erenerdemM/Ege_Eagle_Ultrasonik/docs/GITHUB_RELEASE_PUSH_REPORT.md

# EAGLEULTRASONİK — GITHUB RELEASE PUSH REPORT

---

## 1. Executive Summary

This report documents the official release and push of the **EAGLEULTRASONiK Software / Loop Prototype Baseline** to the remote GitHub repository.

All active firmware modules, Nextion HMI assets, automated mock and physical Hardware-in-the-Loop test suites, build/flash tools, Agent OS operational rules/skills, and authoritative project documentation have been compiled, verified, committed, and pushed.

### Master Release Classification:
```text
GITHUB RELEASE — PUSHED
SOFTWARE / LOOP PROTOTYPE — READY FOR FINAL CLOSURE
FINAL HARDWARE VALIDATION — DEFERRED (DR-001, DR-002, DR-003)
```

---

## 2. Release & Remote Metadata

| Parameter | Authoritative Value |
| :--- | :--- |
| **Commit Hash** | [`6736d40d0eaaec2aaf6b98c35310447c43186bd3`](https://github.com/erenerdemM/Ege_Eagle_Ultrasonik/commit/6736d40d0eaaec2aaf6b98c35310447c43186bd3) |
| **Commit Subject** | `release: EAGLEULTRASONiK software-loop prototype baseline` |
| **Branch** | `main` |
| **Remote Repository** | `origin` (`https://github.com/erenerdemM/Ege_Eagle_Ultrasonik.git`) |
| **Push Status** | `fff821a..6736d40 main -> main` (**SUCCESS — PUSHED**) |
| **Working Tree** | Clean (`nothing to commit, working tree clean`) |

---

## 3. Git Changeset Breakdown

- **Total Staged & Committed Changes:** **232 files** (16,803 insertions, 20,205 deletions).
- **Files Modified (16 files):**
  - STM32 Core Sources: `esp32_uart.c`, `main.c`, `system_state.c`, `ultrasonic_pwm.c`, `x9c103s.c`, `heater_relay.c`, `process_timer.c`
  - STM32 Core Headers: `main.h`, `system_state.h`, `x9c103s.h`
  - ESP32 Firmware: `esp32/ekran_kontrol/ekran_kontrol.ino`
  - Nextion HMI GUI: `EKRAN/arayuz.HMI`
  - Active Test Suites: `test_hil_uart.py`, `test_hmi_mock.py`, `test_rs485_mock.py`
  - Build Script: `tools/build_stm32.sh`
- **Files Added (72 files):**
  - Authoritative Project Documentation: 64 comprehensive reports in `docs/`
  - Test & Diagnostics Tools: `id_full_lifecycle_test.py`, `list_serial_devices.py`, `live_monitor.py`
  - Build Tooling: `tools/build_stm32.ps1`
  - Developer Scratch Utilities: `scratch/restore_baseline.py`, `scratch/run_hil_tests.py`
- **Files Deleted (144 files):**
  - Historical Subagent Milestone Reports: 86 files in `.agent/reports/`
  - Root Historical Phase Reports: 58 superseded markdown drafts (`PHASE_6_2_*.md`, `FINAL_*.md`, `RS485_*.md`, etc.)

---

## 4. Pre-Release Test Verification Baseline

```text
======================================================================
  AUTOMATED VERIFICATION CAMPAIGN (100% PASS RATE):
  --------------------------------------------------------------------
  1. HMI Software Mock Suite (test_hmi_mock.py):        55 / 55 PASSED
  2. RS485 Protocol Mock Suite (test_rs485_mock.py):    37 / 37 PASSED
  3. Physical HIL Campaign (test_hil_uart.py):          40 / 40 PASSED (95.42s)
  --------------------------------------------------------------------
  TOTAL ACCEPTANCE TESTS EXECUTED:                     132 / 132 PASSED
  REGRESSION FAILURES / BLOCKED TESTS:                         0
======================================================================
```

---

## 5. Firmware Build and Hardware Flashing Verification

### 5.1 STM32 Compiler Build
- **Toolchain:** ARM GNU Toolchain (`arm-none-eabi-gcc 12.2.1`)
- **Compilation Result:** **0 Errors, 0 Warnings**
- **Memory Utilization:**
  - Flash Text: `83,304 bytes`
  - Initialized Data: `2,540 bytes`
  - BSS SRAM: `2,692 bytes`
  - Total Dec: `88,536 bytes` (Flash Usage: ~16.4% of 512KB)

### 5.2 Physical Target Flashing
- **Probe / Interface:** ST-Link V3 / OpenOCD 0.12.0 via SWD (1000 kHz)
- **Target Microcontroller:** STM32G474RET6 (`001400183235510230393936`)
- **Flashing Result:**
  ```text
  ** Programming Started **
  ** Programming Finished **
  ** Verify Started **
  ** Verified OK **
  ** Resetting Target **
  ```

---

## 6. Factory Baseline Restoration

Following test execution and firmware flashing, the physical hardware baseline was restored and verified via `scratch/restore_baseline.py`:

```text
======================================================================
  TARGET TELEMETRY READBACK (CONFIRMED):
  STAT,1,IDLE,0,589,0,0,28,0,2,0
  --------------------------------------------------------------------
  - Tank ID:            1
  - Operating Mode:     SYS_MODE_IDLE
  - Remaining Time:     0 s
  - Temperature:        58.9 °C
  - Relay State:        0 (OFF)
  - Actual Power:       0 %
  - Center Frequency:   28 kHz (Step Position 40)
  - Fault Code:         0 (NONE)
  - Provisioning State: 2 (COMMISSIONED)
  - Sweep Status:       0 (OFF)
======================================================================
```

---

## 7. Known Production & Hardware-Deferred Items

1. **Production Software Improvements (Non-Blocking):**
   - `RSK-010`: Flash-erase interrupt masking improvement before production.
   - `RSK-013`: CRC8 checksum protection enhancement for ASCII telemetry frames.
   - `RSK-011`, `RSK-012`, `RSK-014`, `RSK-015`: Usability and architectural refinements accepted for later production phases.
2. **Physical Hardware Validation (Hardware-Deferred):**
   - `DR-001`: Physical PT100 probe RTD calibration and 220V AC heater load validation.
   - `DR-002`: Physical ultrasonic transducer acoustic resonance tracking across 25–43 kHz.
   - `DR-003`: Physical liquid tank cavitation dissolved oxygen (DO) PPM reduction validation.

---

## 8. Final Status

```text
GITHUB RELEASE — PUSHED
```

The repository has been pruned, fully tested, built, flashed, restored to baseline, committed, and pushed to GitHub `origin/main`.

---
*Report generated on 2026-08-17. Release lifecycle complete.*
