erenerdemM/Ege_Eagle_Ultrasonik/docs/P1_BATCH1_IMPLEMENTATION_REPORT.md

# EAGLEULTRASONİK — P1 REMEDIATION BATCH #1 IMPLEMENTATION REPORT

---

## 1. Executive Summary

This report documents the implementation, build, physical flashing, and multi-tier verification of **P1 Remediation Batch #1** for the EAGLEULTRASONiK dual-core ultrasonic generator platform.

Batch #1 targets the three STM32 firmware and low-level protocol risks identified during Phase 15 triage:
- **RSK-005:** Telemetry Buffer Safety (`snprintf` buffer over-read clamping)
- **RSK-007:** UART Error Recovery (ORE/FE/NE/PE error clearing & deterministic RX re-arm)
- **RSK-006:** DEGAS Mode Provisioning Interlock (Layer 2 commissioning lockout in `SYS_MODE_DEGAS`)

All three risks were remediated through surgical, minimal-diff modifications strictly within the STM32 UART subsystem, followed by clean builds, physical target programming via OpenOCD SWD, targeted regression verification, and full regression testing across both mock and physical HIL environments.

### Master Batch Status:
```text
P1 BATCH #1 REMEDIATION — COMPLETE (RSK-005: PASS | RSK-007: PASS | RSK-006: PASS)
```

---

## 2. Risk-by-Risk Implementation Details

### 2.1 RSK-005 Implementation (Telemetry Buffer Boundary Clamping)
* **Target File:** [`STM32/Ultrasonik_G4_Master/Core/Src/esp32_uart.c:732-758`](file:///c:/Users/ern0e/EAGLEULTRASONiK/STM32/Ultrasonik_G4_Master/Core/Src/esp32_uart.c#L732-L758)
* **Root Cause:** `snprintf()` returns the total length that *would have been written* if the buffer were unbounded (ISO C99 §7.19.6.5). If formatting expanded beyond `TX_LINE_MAX` (64 bytes), passing raw `len` to `HAL_UART_Transmit_IT` resulted in an out-of-bounds buffer read from SRAM.
* **Remediation Applied:** Added deterministic upper-bound clamping to `len`:
  ```c
  if (len <= 0)
  {
    return;
  }

  if (len >= TX_LINE_MAX)
  {
    len = TX_LINE_MAX - 1;
    tx_line[len] = '\0';
  }

  tx_busy = 1;
  g_bus_diag.tx_frame_count++;
  RS485_TX_ENABLE();
  HAL_UART_Transmit_IT(&huart3, (uint8_t *)tx_line, (uint16_t)len);
  ```
* **Acceptance Invariants Met:** Transmitted length strictly bounded by `TX_LINE_MAX - 1` (63 bytes); normal STAT telemetry framing and 10-field CSV schema perfectly preserved.

---

### 2.2 RSK-007 Implementation (Deterministic UART RX Error Recovery)
* **Target File:** [`STM32/Ultrasonik_G4_Master/Core/Src/esp32_uart.c:808-832`](file:///c:/Users/ern0e/EAGLEULTRASONiK/STM32/Ultrasonik_G4_Master/Core/Src/esp32_uart.c#L808-L832)
* **Root Cause:** In `HAL_UART_ErrorCallback()`, Overrun (ORE), Framing (FE), Noise (NE), and Parity (PE) error flags in USART3 ISR registers were not explicitly cleared, and the return value of `HAL_UART_Receive_IT` was ignored. If the driver state remained locked or busy, RX failed to re-arm, permanently silencing the slave node.
* **Remediation Applied:** Explicitly cleared all hardware error flags, reset HAL error state, and implemented a fail-safe abort-and-rearm fallback if the initial `HAL_UART_Receive_IT` call returns non-OK:
  ```c
  void HAL_UART_ErrorCallback(UART_HandleTypeDef *huart)
  {
    if (huart->Instance != USART3)
    {
      return;
    }

    /* Clear all UART error flags (Overrun, Noise, Framing, Parity) */
    __HAL_UART_CLEAR_OREFLAG(huart);
    __HAL_UART_CLEAR_NEFLAG(huart);
    __HAL_UART_CLEAR_FEFLAG(huart);
    __HAL_UART_CLEAR_PEFLAG(huart);
    huart->ErrorCode = HAL_UART_ERROR_NONE;

    /* Overrun/framing/noise errors abort the pending HAL_UART_Receive_IT();
     * discard the partial line and immediately re-arm so a single glitch
     * never permanently silences the link (RX must never be left dead). */
    RS485_RX_ENABLE();
    rx_index = 0;
    g_bus_diag.rx_dropped_count++;
    tx_busy = 0; /* Reset TX lockup state so status transmission recovers after error */

    if (HAL_UART_Receive_IT(&huart3, &rx_byte, 1) != HAL_OK)
    {
      /* If re-arm failed due to state lock, force abort receive and re-arm deterministically */
      (void)HAL_UART_AbortReceive(&huart3);
      (void)HAL_UART_Receive_IT(&huart3, &rx_byte, 1);
    }
  }
  ```
* **Acceptance Invariants Met:** Zero blocking loops or delays in ISR; all hardware error flags cleared; RX path deterministically re-armed.

---

### 2.3 RSK-006 Implementation (DEGAS Mode Provisioning Interlock)
* **Target File:** [`STM32/Ultrasonik_G4_Master/Core/Src/esp32_uart.c:224-239`](file:///c:/Users/ern0e/EAGLEULTRASONiK/STM32/Ultrasonik_G4_Master/Core/Src/esp32_uart.c#L224-L239)
* **Root Cause:** Layer 2 commissioning command interlocks (`STAGE_ID`, `ASSIGN_ID`, `SET_ID:`, `RESET_ID`, `DISCOVER`, `COMMIT_ID`) only checked `g_system_state.mode == SYS_MODE_RUNNING`, permitting flash erase/write operations and identity mutations during active `SYS_MODE_DEGAS`.
* **Remediation Applied:** Extended the Layer 2 interlock check to include `SYS_MODE_DEGAS`:
  ```c
  /* Requirement 2: Layer 2 SYS_MODE_RUNNING and SYS_MODE_DEGAS Interlock at STM32 Slave Level */
  if (g_system_state.mode == SYS_MODE_RUNNING || g_system_state.mode == SYS_MODE_DEGAS)
  {
    if (strncmp(cmd, "STAGE_ID", 8) == 0  ||
        strncmp(cmd, "ASSIGN_ID", 9) == 0 ||
        strncmp(cmd, "SET_ID:", 7) == 0   ||
        strncmp(cmd, "RESET_ID", 8) == 0  ||
        strncmp(cmd, "DISCOVER", 8) == 0  ||
        strncmp(cmd, "COMMIT_ID", 9) == 0)
    {
      const char *err_msg = "ERR:LOCKED_SYS_RUNNING\n";
      RS485_Transmit_Blocking((const uint8_t *)err_msg, (uint16_t)strlen(err_msg), 10);
      HAL_UART_Transmit(&hlpuart1, (const uint8_t *)err_msg, (uint16_t)strlen(err_msg), 10);
      return; /* REJECT IMMEDIATELY; NO FLASH TOUCH OR STATE MUTATION */
    }
  }
  ```
* **Acceptance Invariants Met:** Full mode symmetry restored; commissioning commands strictly rejected during both `RUNNING` and `DEGAS`; normal commissioning remains 100% operational in `IDLE`.

---

## 3. Files Changed

| Modified File | Subsystem | Purpose of Modification | Lines Changed |
| :--- | :--- | :--- | :--- |
| [`STM32/.../Core/Src/esp32_uart.c`](file:///c:/Users/ern0e/EAGLEULTRASONiK/STM32/Ultrasonik_G4_Master/Core/Src/esp32_uart.c) | STM32 Firmware | Implemented RSK-005 buffer clamp, RSK-007 error flags/re-arm, RSK-006 DEGAS interlock | +22 / -4 |
| [`test_rs485_mock.py`](file:///c:/Users/ern0e/EAGLEULTRASONiK/test_rs485_mock.py) | Mock Test Suite | Added mock regression tests for RSK-005, RSK-006, RSK-007; updated mock slave node interlock | +48 / -2 |
| [`test_hil_uart.py`](file:///c:/Users/ern0e/EAGLEULTRASONiK/test_hil_uart.py) | Physical HIL Suite | Added physical HIL regression tests for RSK-005, RSK-006, RSK-007; aligned CLEAR_FAULT recovery in setup/tests | +52 / -4 |

---

## 4. Regression Tests Added

1. **`test_rsk005_telemetry_buffer_boundary_clamping`:**
   - **Mock Suite:** [`test_rs485_mock.py:788`](file:///c:/Users/ern0e/EAGLEULTRASONiK/test_rs485_mock.py#L788)
   - **Physical HIL Suite:** [`test_hil_uart.py:1347`](file:///c:/Users/ern0e/EAGLEULTRASONiK/test_hil_uart.py#L1347)
   - **Verification:** Formatted STAT frame length strictly bounded by buffer capacity ($\le 63$ chars); valid parsing verified.

2. **`test_rsk006_degas_mode_provisioning_command_rejection`:**
   - **Mock Suite:** [`test_rs485_mock.py:797`](file:///c:/Users/ern0e/EAGLEULTRASONiK/test_rs485_mock.py#L797)
   - **Physical HIL Suite:** [`test_hil_uart.py:1355`](file:///c:/Users/ern0e/EAGLEULTRASONiK/test_hil_uart.py#L1355)
   - **Verification:** STAGE_ID and commissioning commands sent during DEGAS mode are immediately rejected with zero identity or state mutation.

3. **`test_rsk007_uart_rx_error_callback_rearm_guarantee`:**
   - **Mock Suite:** [`test_rs485_mock.py:805`](file:///c:/Users/ern0e/EAGLEULTRASONiK/test_rs485_mock.py#L805)
   - **Physical HIL Suite:** [`test_hil_uart.py:1378`](file:///c:/Users/ern0e/EAGLEULTRASONiK/test_hil_uart.py#L1378)
   - **Verification:** Simulates error callback / corrupted line injections; verifies USART3 RX immediately resumes and delivers clean telemetry frames.

---

## 5. Targeted Test Results

```text
============================= test session starts ==============================
test_hil_uart.py::HardwareInLoopTests::test_rsk001_active_hardware_fault_stop_rejection PASSED [ 16%]
test_hil_uart.py::HardwareInLoopTests::test_rsk002_hil_uart_spinlock_timeout_guard PASSED [ 33%]
test_hil_uart.py::HardwareInLoopTests::test_rsk003_hil_setpoint_touch_lockout_in_running PASSED [ 50%]
test_hil_uart.py::HardwareInLoopTests::test_rsk005_telemetry_buffer_boundary_clamping PASSED [ 66%]
test_hil_uart.py::HardwareInLoopTests::test_rsk006_degas_mode_provisioning_command_rejection PASSED [ 83%]
test_hil_uart.py::HardwareInLoopTests::test_rsk007_uart_rx_error_callback_rearm_guarantee PASSED [100%]

======================= 6 passed, 31 deselected in 7.56s =======================
```

---

## 6. Full Regression Results

### 6.1 Mock Test Suites (Host Environment)
```text
test_hmi_mock.py .................................................... [ 58%]
test_rs485_mock.py ...................................                [100%]

============================= 89 passed in 0.26s ==============================
```

### 6.2 Physical Hardware-in-the-Loop Suite (`test_hil_uart.py` on Raspberry Pi)
```text
test_hil_uart.py::HardwareInLoopTests::test_01_id_assignment PASSED      [  2%]
test_hil_uart.py::HardwareInLoopTests::test_02_parameter_transmission PASSED [  5%]
test_hil_uart.py::HardwareInLoopTests::test_03_operation_cycle PASSED    [  8%]
test_hil_uart.py::HardwareInLoopTests::test_04_stop_clears_fault PASSED  [ 10%]
test_hil_uart.py::HardwareInLoopTests::test_05_dual_channel_consistency PASSED [ 13%]
test_hil_uart.py::HardwareInLoopTests::test_06_triac_math PASSED         [ 16%]
test_hil_uart.py::HardwareInLoopTests::test_07_pt100_adc PASSED          [ 18%]
test_hil_uart.py::HardwareInLoopTests::test_08_esp32_internals PASSED    [ 21%]
test_hil_uart.py::HardwareInLoopTests::test_09_id0_discovery_slotted PASSED [ 24%]
test_hil_uart.py::HardwareInLoopTests::test_10_id0_discovery_multi_simulated PASSED [ 27%]
test_hil_uart.py::HardwareInLoopTests::test_11_uid_mismatch_rejection PASSED [ 29%]
test_hil_uart.py::HardwareInLoopTests::test_12_id_duplicate_rejection PASSED [ 32%]
test_hil_uart.py::HardwareInLoopTests::test_13_atomic_swap_flow PASSED   [ 35%]
test_hil_uart.py::HardwareInLoopTests::test_14_staging_discovery_isolation PASSED [ 37%]
test_hil_uart.py::HardwareInLoopTests::test_15_running_commissioning_rejection PASSED [ 40%]
test_hil_uart.py::HardwareInLoopTests::test_16_safety_watchdog_comm_loss PASSED [ 43%]
test_hil_uart.py::HardwareInLoopTests::test_17_physical_loopback_readback PASSED [ 45%]
test_hil_uart.py::HardwareInLoopTests::test_deg_01_full_degas_hil_lifecycle PASSED [ 48%]
test_hil_uart.py::HardwareInLoopTests::test_f1_set_freq_28 PASSED        [ 51%]
test_hil_uart.py::HardwareInLoopTests::test_f2_set_freq_40 PASSED        [ 54%]
test_hil_uart.py::HardwareInLoopTests::test_f3_set_freq_invalid PASSED   [ 56%]
test_hil_uart.py::HardwareInLoopTests::test_rsk001_active_hardware_fault_stop_rejection PASSED [ 59%]
test_hil_uart.py::HardwareInLoopTests::test_rsk002_hil_uart_spinlock_timeout_guard PASSED [ 62%]
test_hil_uart.py::HardwareInLoopTests::test_rsk003_hil_setpoint_touch_lockout_in_running PASSED [ 64%]
test_hil_uart.py::HardwareInLoopTests::test_rsk005_telemetry_buffer_boundary_clamping PASSED [ 67%]
test_hil_uart.py::HardwareInLoopTests::test_rsk006_degas_mode_provisioning_command_rejection PASSED [ 70%]
test_hil_uart.py::HardwareInLoopTests::test_rsk007_uart_rx_error_callback_rearm_guarantee PASSED [ 72%]
test_hil_uart.py::HardwareInLoopTests::test_swp_01_idle_sweep_off_and_on PASSED [ 75%]
test_hil_uart.py::HardwareInLoopTests::test_swp_02_start_with_and_without_sweep PASSED [ 78%]
test_hil_uart.py::HardwareInLoopTests::test_swp_03_set_freq_terminates_sweep PASSED [ 81%]
test_hil_uart.py::HardwareInLoopTests::test_swp_04_step_increment_configuration PASSED [ 83%]
test_hil_uart.py::HardwareInLoopTests::test_swp_05_degas_mode_sweep_interlock PASSED [ 86%]
test_hil_uart.py::HardwareInLoopTests::test_swp_06_sweep_span_configuration PASSED [ 89%]
test_hil_uart.py::HardwareInLoopTests::test_swp_07_sweep_period_configuration PASSED [ 91%]
test_hil_uart.py::HardwareInLoopTests::test_swp_08_parameter_independence PASSED [ 94%]
test_hil_uart.py::HardwareInLoopTests::test_swp_09_stop_safestop_cleanup_and_persistence PASSED [ 97%]
test_hil_uart.py::HardwareInLoopTests::test_swp_10_endurance_stability_sample PASSED [100%]

======================== 37 passed in 90.32s (0:01:30) =========================
```

---

## 7. Build and Physical Flash Verification

### 7.1 Compilation Output (ARM GNU Toolchain 13.3.rel1)
* **Windows Clean Build:** `build-stm32/Ultrasonik_G4_Master.elf` (0 errors, 0 warnings)
  ```text
     text    data     bss     dec     hex filename
    67968    1804    3412   73184   11de0 Ultrasonik_G4_Master.elf
  ```
* **RPi Clean Build:** `build-stm32/Ultrasonik_G4_Master.elf` (0 errors, 0 warnings)
  ```text
     text    data     bss     dec     hex filename
    83304    2540    2692   88536   159d8 Ultrasonik_G4_Master.elf
  ```

### 7.2 OpenOCD SWD Programming Log
* **Target Hardware:** STM32G474RET6 (UID24 `001400183235510230393936`)
* **Interface:** ST-LINK V3J16M9 via SWD @ 1000 kHz
* **Flash Operations:**
  ```text
  ** Programming Started **
  Info : device idcode = 0x20036469 (STM32G47/G48xx - Rev 'unknown' : 0x2003)
  Info : RDP level 0 (0xAA)
  Info : flash size = 512 KiB
  Info : flash mode : dual-bank
  ** Programming Finished **
  ** Verify Started **
  ** Verified OK **
  ** Resetting Target **
  ```

---

## 8. Blocked and Deferred Tests Reconciliation

* **Blocked Tests (12 items):** In earlier test runs where transient fault states prevented mode transitions, 12 AC mains zero-cross dependent tests were blocked. With the addition of deterministic `CLEAR_FAULT` in `setUp()` and the baseline restoration procedure, **all 37 physical HIL tests ran cleanly to PASS status** in the full regression run.
* **Deferred Test (DR-001):** `test_17_physical_loopback_readback` was executed and **PASSED** on the active test channel.

---

## 9. Baseline Restoration Record

Following completion of the test suite, the physical DUT was restored to the authoritative baseline state via automated script:

```text
Restored Authoritative Defaults:
  - Mode: IDLE
  - Tank ID: 1 (UID: 001400183235510230393936)
  - Frequency: 28 kHz
  - Power: 100%
  - Fault Flags: 0x00 (Clean)
  - Sweep: OFF (span: 2 kHz, period: 400 ms, step inc: 4)
  - DEGAS Config: 15 min, 100% power, 28 kHz, ON: 1000 ms, OFF: 500 ms, Temp Ctrl: OFF (50 °C)

Telemetry Readback Confirmation:
  STAT,1,IDLE,0,603,0,0,28,0,2,0
  STAT,1,IDLE,0,595,0,0,28,0,2,0
  STAT,1,IDLE,0,596,0,0,28,0,2,0
  STAT,1,IDLE,0,592,0,0,28,0,2,0
  STAT,1,IDLE,0,595,0,0,28,0,2,0
```

---

## 10. Remaining Active P1 Risks Ledger

With Batch #1 complete, the remaining P1 risks in the project registry are:

| Risk ID | Title | Target Area | Batch Status | Next Scheduled Phase |
| :--- | :--- | :--- | :--- | :--- |
| **RSK-009** | Stale UI Status After RS485 Disconnection | ESP32 HMI Watchdog | OPEN | **P1 Remediation Batch #2** |
| **RSK-004** | ESP32 Master Response Blind Spot (ACK/NACK/ERR) | ESP32 Protocol Parser | OPEN | **P1 Remediation Batch #2** |
| **RSK-008** | Unauthenticated Administrative Commands | ESP32 HMI Security / NVS | OPEN | **P1 Remediation Batch #2** |

---

## 11. Final Risk Status Determination

| Risk ID | Title | Final Verification Status | Evidence Level |
| :--- | :--- | :--- | :--- |
| **RSK-005** | Telemetry Buffer Safety (`snprintf` clamp) | **PASS** | Physical HIL + Mock Suite Verified |
| **RSK-007** | UART Error Recovery (ORE/FE/NE/PE re-arm) | **PASS** | Physical HIL + Mock Suite Verified |
| **RSK-006** | DEGAS Mode Provisioning Interlock | **PASS** | Physical HIL + Mock Suite Verified |

---
*Report generated and validated under Phase 16: P1 Remediation Batch #1. Zero unrelated modules were modified.*
