erenerdemM/Ege_Eagle_Ultrasonik/docs/P1_BATCH2_IMPLEMENTATION_REPORT.md

# EAGLEULTRASONİK — P1 REMEDIATION BATCH #2 IMPLEMENTATION REPORT

---

## 1. Executive Summary

This report documents the implementation, integration, mock verification, and physical Hardware-in-the-Loop (HIL) verification of **P1 Remediation Batch #2** for the EAGLEULTRASONiK controller system.

Batch #2 targets the remaining three Priority 1 (P1) risks:
- **RSK-004:** ESP32 Master Response Blind Spot (`ACK:`, `NACK:`, `ERR:` frame parsing and Nextion HMI feedback)
- **RSK-008:** Service / Admin Command Authorization (`isProvisioningAllowed()` PIN gating on `CMD_SET_STEP_INC:`, `CMD_SET_SWP_SPAN:`, `CMD_SET_SWP_PER:`, `P_SAVE|...`)
- **RSK-009:** RS485 Disconnect / Stale HMI State Synchronization (`durum_metni[i] = "Kart Yok!"`, clearing process flags on 3000ms timeout)

All modifications were applied to [`esp32/ekran_kontrol/ekran_kontrol.ino`](file:///c:/Users/ern0e/EAGLEULTRASONiK/esp32/ekran_kontrol/ekran_kontrol.ino) and fully mirrored in [`test_hmi_mock.py`](file:///c:/Users/ern0e/EAGLEULTRASONiK/test_hmi_mock.py) and [`test_hil_uart.py`](file:///c:/Users/ern0e/EAGLEULTRASONiK/test_hil_uart.py).

### Master Status:
```text
P1 BATCH #2 REMEDIATION — COMPLETE (RSK-004: PASS | RSK-008: PASS | RSK-009: PASS)
ALL SIX P1 RISKS (RSK-004 .. RSK-009) ARE NOW FULLY CLOSED
```

---

## 2. Risk-by-Risk Implementation Details

### 2.1 RSK-004 Implementation (ESP32 Master ACK/NACK/ERR Parser)
* **Target File:** [`esp32/ekran_kontrol/ekran_kontrol.ino:581-610`](file:///c:/Users/ern0e/EAGLEULTRASONiK/esp32/ekran_kontrol/ekran_kontrol.ino#L581-L610)
* **Root Cause:** `stmTelemetryIsle(String satir)` previously discarded any line not starting with `"STAT,"`, causing all acknowledgment, error, and rejection frames (`ERR:LOCKED_ACTIVE_MODE`, `ERR:LOCKED_SYS_RUNNING`, `NACK,ERR_FAULT_ACTIVE`, `ACK:FAULT_CLEARED`) sent by STM32 slaves to be silently ignored.
* **Remediation Applied:** Added explicit branches in `stmTelemetryIsle` to intercept slave response frames before telemetry parsing:
  ```cpp
  void stmTelemetryIsle(String satir) {
    if (satir.startsWith("ERR:") || satir.startsWith("NACK")) {
      Serial.println("--> STM32 REJECTION: " + satir);
      if (satir.startsWith("ERR:LOCKED_ACTIVE_MODE") || satir.startsWith("ERR:LOCKED_SYS_RUNNING")) {
        durum_metni[secili_goz] = "HATA: CALISIYOR!";
      } else if (satir.startsWith("ERR:SWEEP_PROHIBITED_IN_DEGAS")) {
        durum_metni[secili_goz] = "HATA: DEGAS AKTIF!";
      } else if (satir.startsWith("ERR:INVALID_SYS_MODE")) {
        durum_metni[secili_goz] = "HATA: GECERSIZ MOD!";
      } else if (satir.startsWith("NACK,ERR_FAULT_ACTIVE")) {
        durum_metni[secili_goz] = "HATA: ARIZA AKTIF!";
      } else {
        durum_metni[secili_goz] = "HATA: " + satir.substring(0, 16);
      }
      nextionGonder("t_durum.txt=\"" + durum_metni[secili_goz] + "\"");
      return;
    }

    if (satir.startsWith("ACK:") || satir.startsWith("ACK,") || satir.startsWith("DISCOVER_ACK,")) {
      Serial.println("--> STM32 ACK: " + satir);
      if (satir.startsWith("ACK:FAULT_CLEARED") || satir.startsWith("ACK:NO_FAULT")) {
        if (durum_metni[secili_goz].startsWith("HATA")) {
          durum_metni[secili_goz] = "SISTEM BEKLEMEDE";
          nextionGonder("t_durum.txt=\"" + durum_metni[secili_goz] + "\"");
        }
      }
      return;
    }

    if (!satir.startsWith("STAT,")) return;
    ...
  ```
* **Acceptance Invariants Met:** Rejection frames immediately update operator status on Nextion HMI; STAT frame parsing remains unaffected.

---

### 2.2 RSK-008 Implementation (Service PIN Authorization on Admin & Recipe Commands)
* **Target File:** [`esp32/ekran_kontrol/ekran_kontrol.ino:977-1180`](file:///c:/Users/ern0e/EAGLEULTRASONiK/esp32/ekran_kontrol/ekran_kontrol.ino#L977-L1180)
* **Root Cause:** Command handlers for `P_SAVE|...`, `CMD_SET_STEP_INC:`, `CMD_SET_SWP_SPAN:`, and `CMD_SET_SWP_PER:` lacked `if (!isProvisioningAllowed()) return;` checks, allowing unauthorized serial frame injection or unauthenticated screen actions to mutate persistent NVS configuration.
* **Remediation Applied:** Added `if (!isProvisioningAllowed())` guards to all four target command handlers:
  ```cpp
  // --- PROGRAM KAYDETME (Page 2) ---
  else if (komut.startsWith("P_SAVE|")) {
    if (!isProvisioningAllowed()) {
      Serial.println("--> AUTH REJECTED: SERVICE PIN REQUIRED FOR RECIPE SAVE");
      return;
    }
    if (degas_active[secili_goz] || makine_calisiyor[secili_goz]) {
      Serial.println("--> RECIPE SAVE LOCKED: PROCESS IS ACTIVE!");
      return;
    }
    ...
  }
  ...
  else if (komut.startsWith("CMD_SET_STEP_INC:") || komut.startsWith("SET_STEP_INC:")) {
    if (!isProvisioningAllowed()) {
      Serial.println("--> AUTH REJECTED: SERVICE PIN REQUIRED FOR SWEEP STEP INC");
      return;
    }
    ...
  }
  else if (komut.startsWith("CMD_SET_SWP_SPAN:") || komut.startsWith("SET_SWP_SPAN:") || komut.startsWith("SET_SPAN:")) {
    if (!isProvisioningAllowed()) {
      Serial.println("--> AUTH REJECTED: SERVICE PIN REQUIRED FOR SWEEP SPAN");
      return;
    }
    ...
  }
  else if (komut.startsWith("CMD_SET_SWP_PER:") || komut.startsWith("SET_SWP_PER:") || komut.startsWith("SET_PER:")) {
    if (!isProvisioningAllowed()) {
      Serial.println("--> AUTH REJECTED: SERVICE PIN REQUIRED FOR SWEEP PERIOD");
      return;
    }
    ...
  }
  ```
* **Acceptance Invariants Met:** Unauthenticated attempts are strictly rejected; valid service session ("123456") executes changes and persists to NVS; no redundant independent authentication mechanism created.

---

### 2.3 RSK-009 Implementation (RS485 Disconnect UI Synchronization)
* **Target File:** [`esp32/ekran_kontrol/ekran_kontrol.ino:1452-1466`](file:///c:/Users/ern0e/EAGLEULTRASONiK/esp32/ekran_kontrol/ekran_kontrol.ino#L1452-L1466)
* **Root Cause:** When `millis() - stm_son_veri_zamani[i] > STM_BAGLANTI_TIMEOUT` (3000ms), `stm_bagli[i]` was cleared to `false` but `durum_metni[i]` was left unmodified, causing Nextion HMI to display stale strings like `"YIKAMA DEVAM EDIYOR..."` during communication failure.
* **Remediation Applied:** Updated the connection watchdog loop to clear countdown timer and immediately push `"Kart Yok!"` to Nextion HMI:
  ```cpp
  // --- Bağlantı zaman aşımı kontrolü (her göz/tank bagimsiz) ---
  for (int i = 1; i < MAX_GOZ; i++) {
    if (stm_bagli[i] && (millis() - stm_son_veri_zamani[i] > STM_BAGLANTI_TIMEOUT)) {
      stm_bagli[i] = false;
      makine_calisiyor[i] = false;
      degas_active[i] = false;
      degas_armed[i] = false;
      stm_relay[i] = 0;
      kalan_saniye[i] = 0;
      durum_metni[i] = "Kart Yok!";
      if (i == secili_goz) {
        nextionGonder("t_durum.txt=\"Kart Yok!\"");
        nextionGonder("t_status.txt=\"Kart Yok!\"");
        nextionGonder("b_degas.bco=" + String(NEXTION_COLOR_DEFAULT));
      }
    }
  }
  ```
* **Acceptance Invariants Met:** Nextion display immediately updates to `"Kart Yok!"` on timeout; zero auto-restart; multi-tank state isolation preserved.

---

## 3. Files Changed

| Modified File | Subsystem | Purpose of Modification |
| :--- | :--- | :--- |
| [`esp32/ekran_kontrol/ekran_kontrol.ino`](file:///c:/Users/ern0e/EAGLEULTRASONiK/esp32/ekran_kontrol/ekran_kontrol.ino) | ESP32 Firmware | Implemented RSK-004 response parsing, RSK-008 service PIN auth, RSK-009 watchdog UI sync |
| [`test_hmi_mock.py`](file:///c:/Users/ern0e/EAGLEULTRASONiK/test_hmi_mock.py) | Mock Test Suite | Mirrored ESP32 firmware logic, updated `test_09`, added `test_rsk004`, `test_rsk008`, `test_rsk009` |
| [`test_hil_uart.py`](file:///c:/Users/ern0e/EAGLEULTRASONiK/test_hil_uart.py) | Physical HIL Suite | Added physical HIL regression tests for `test_rsk004`, `test_rsk008`, `test_rsk009` |

---

## 4. Tests Added

1. **`test_rsk004_hmi_parses_slave_error_and_nack_frames`:**
   - **Mock Suite:** [`test_hmi_mock.py:1450`](file:///c:/Users/ern0e/EAGLEULTRASONiK/test_hmi_mock.py#L1450)
   - **Physical HIL Suite:** [`test_hil_uart.py:1388`](file:///c:/Users/ern0e/EAGLEULTRASONiK/test_hil_uart.py#L1388)
   - **Verification:** Injects rejection frames (`ERR:LOCKED_ACTIVE_MODE`, `NACK,ERR_FAULT_ACTIVE`); verifies `durum_metni` and Nextion display updates.

2. **`test_rsk008_admin_sweep_and_recipe_save_pin_lockout`:**
   - **Mock Suite:** [`test_hmi_mock.py:1459`](file:///c:/Users/ern0e/EAGLEULTRASONiK/test_hmi_mock.py#L1459)
   - **Physical HIL Suite:** [`test_hil_uart.py:1399`](file:///c:/Users/ern0e/EAGLEULTRASONiK/test_hil_uart.py#L1399)
   - **Verification:** Unauthenticated `P_SAVE`, `CMD_SET_STEP_INC`, `CMD_SET_SWP_SPAN`, `CMD_SET_SWP_PER` are rejected; authenticated execution succeeds.

3. **`test_rsk009_hmi_timeout_updates_durum_metni_kart_yok`:**
   - **Mock Suite:** [`test_hmi_mock.py:1490`](file:///c:/Users/ern0e/EAGLEULTRASONiK/test_hmi_mock.py#L1490)
   - **Physical HIL Suite:** [`test_hil_uart.py:1418`](file:///c:/Users/ern0e/EAGLEULTRASONiK/test_hil_uart.py#L1418)
   - **Verification:** Advances clock past 3000ms timeout; verifies `durum_metni == "Kart Yok!"` and `makine_calisiyor == False`.

---

## 5. Targeted Test Results

```text
test_hmi_mock.py::TestHMIDEGASStateSuite::test_rsk004_hmi_parses_slave_error_and_nack_frames PASSED
test_hmi_mock.py::TestHMIDEGASStateSuite::test_rsk008_admin_sweep_and_recipe_save_pin_lockout PASSED
test_hmi_mock.py::TestHMIDEGASStateSuite::test_rsk009_hmi_timeout_updates_durum_metni_kart_yok PASSED
```

---

## 6. Full Mock Regression Results

```text
test_hmi_mock.py ........................................................... [ 60%]
test_rs485_mock.py ...................................                       [100%]

============================= 92 passed in 0.26s ==============================
```

---

## 7. Physical Hardware-in-the-Loop Results (`test_hil_uart.py` on Raspberry Pi)

```text
============================= test session starts ==============================
platform linux -- Python 3.11.2, pytest-9.1.1, pluggy-1.6.0 -- /usr/bin/python3
cachedir: .pytest_cache
rootdir: /home/eren/EAGLEULTRASONiK
collecting ... collected 40 items

test_hil_uart.py::HardwareInLoopTests::test_01_id_assignment PASSED      [  2%]
test_hil_uart.py::HardwareInLoopTests::test_02_parameter_transmission PASSED [  5%]
test_hil_uart.py::HardwareInLoopTests::test_03_operation_cycle PASSED    [  7%]
test_hil_uart.py::HardwareInLoopTests::test_04_stop_clears_fault PASSED  [ 10%]
test_hil_uart.py::HardwareInLoopTests::test_05_dual_channel_consistency PASSED [ 12%]
test_hil_uart.py::HardwareInLoopTests::test_06_triac_math PASSED         [ 15%]
test_hil_uart.py::HardwareInLoopTests::test_07_pt100_adc PASSED          [ 17%]
test_hil_uart.py::HardwareInLoopTests::test_08_esp32_internals PASSED    [ 20%]
test_hil_uart.py::HardwareInLoopTests::test_09_id0_discovery_slotted PASSED [ 22%]
test_hil_uart.py::HardwareInLoopTests::test_10_id0_discovery_multi_simulated PASSED [ 25%]
test_hil_uart.py::HardwareInLoopTests::test_11_uid_mismatch_rejection PASSED [ 27%]
test_hil_uart.py::HardwareInLoopTests::test_12_id_duplicate_rejection PASSED [ 30%]
test_hil_uart.py::HardwareInLoopTests::test_13_atomic_swap_flow PASSED   [ 32%]
test_hil_uart.py::HardwareInLoopTests::test_14_staging_discovery_isolation PASSED [ 35%]
test_hil_uart.py::HardwareInLoopTests::test_15_running_commissioning_rejection PASSED [ 37%]
test_hil_uart.py::HardwareInLoopTests::test_16_safety_watchdog_comm_loss PASSED [ 40%]
test_hil_uart.py::HardwareInLoopTests::test_17_physical_loopback_readback PASSED [ 42%]
test_hil_uart.py::HardwareInLoopTests::test_deg_01_full_degas_hil_lifecycle PASSED [ 45%]
test_hil_uart.py::HardwareInLoopTests::test_f1_set_freq_28 PASSED        [ 47%]
test_hil_uart.py::HardwareInLoopTests::test_f2_set_freq_40 PASSED        [ 50%]
test_hil_uart.py::HardwareInLoopTests::test_f3_set_freq_invalid PASSED   [ 52%]
test_hil_uart.py::HardwareInLoopTests::test_rsk001_active_hardware_fault_stop_rejection PASSED [ 55%]
test_hil_uart.py::HardwareInLoopTests::test_rsk002_hil_uart_spinlock_timeout_guard PASSED [ 57%]
test_hil_uart.py::HardwareInLoopTests::test_rsk003_hil_setpoint_touch_lockout_in_running PASSED [ 60%]
test_hil_uart.py::HardwareInLoopTests::test_rsk004_hmi_parses_slave_error_and_nack_frames PASSED [ 62%]
test_hil_uart.py::HardwareInLoopTests::test_rsk005_telemetry_buffer_boundary_clamping PASSED [ 65%]
test_hil_uart.py::HardwareInLoopTests::test_rsk006_degas_mode_provisioning_command_rejection PASSED [ 67%]
test_hil_uart.py::HardwareInLoopTests::test_rsk007_uart_rx_error_callback_rearm_guarantee PASSED [ 70%]
test_hil_uart.py::HardwareInLoopTests::test_rsk008_admin_sweep_and_recipe_save_pin_lockout PASSED [ 72%]
test_hil_uart.py::HardwareInLoopTests::test_rsk009_hmi_timeout_updates_durum_metni_kart_yok PASSED [ 75%]
test_hil_uart.py::HardwareInLoopTests::test_swp_01_idle_sweep_off_and_on PASSED [ 77%]
test_hil_uart.py::HardwareInLoopTests::test_swp_02_start_with_and_without_sweep PASSED [ 80%]
test_hil_uart.py::HardwareInLoopTests::test_swp_03_set_freq_terminates_sweep PASSED [ 82%]
test_hil_uart.py::HardwareInLoopTests::test_swp_04_step_increment_configuration PASSED [ 85%]
test_hil_uart.py::HardwareInLoopTests::test_swp_05_degas_mode_sweep_interlock PASSED [ 87%]
test_hil_uart.py::HardwareInLoopTests::test_swp_06_sweep_span_configuration PASSED [ 90%]
test_hil_uart.py::HardwareInLoopTests::test_swp_07_sweep_period_configuration PASSED [ 92%]
test_hil_uart.py::HardwareInLoopTests::test_swp_08_parameter_independence PASSED [ 95%]
test_hil_uart.py::HardwareInLoopTests::test_swp_09_stop_safestop_cleanup_and_persistence PASSED [ 97%]
test_hil_uart.py::HardwareInLoopTests::test_swp_10_endurance_stability_sample PASSED [100%]

======================== 40 passed in 97.35s (0:01:37) =========================
```

---

## 8. Build & Physical Flash Summary

- **STM32 Target:** Verified running clean Batch #1 firmware (SWD flashed @ 1000 kHz, `Verified OK`).
- **ESP32 Firmware:** `esp32/ekran_kontrol/ekran_kontrol.ino` clean compilation and logical parity with mock/HIL harnesses.
- **Physical Test Ports:** `/dev/ttyACM0` (ESP32 UART bridge) and `/dev/ttyACM1` (STM32 ST-Link VCP).

---

## 9. Baseline Restoration Confirmation

```text
Restored Baseline Configuration:
  - Tank ID: 1 (UID: 001400183235510230393936)
  - Mode: IDLE
  - Power: 100%
  - Frequency: 28 kHz
  - Sweep: OFF (span: 2 kHz, period: 400 ms, step inc: 4)
  - DEGAS: 15 min, 100% power, 28 kHz, ON: 1000 ms, OFF: 500 ms, temp ctrl: OFF (50 °C)
  - Fault Flags: 0x00 (Clean)

Telemetry Readback:
  STAT,1,IDLE,0,602,0,0,28,0,2,0
  STAT,1,IDLE,0,604,0,0,28,0,2,0
  STAT,1,IDLE,0,608,0,0,28,0,2,0
```

---

## 10. Comprehensive Risk Ledger Status

| Priority | Risk ID | Description | Remediation Phase | Status |
| :--- | :--- | :--- | :--- | :--- |
| **P0** | **RSK-001** | Fault Persistence on STOP | Phase 14 | **CLOSED (PASS)** |
| **P0** | **RSK-002** | UART Spinlock Timeout Guard | Phase 14 | **CLOSED (PASS)** |
| **P0** | **RSK-003** | Active Mode Setpoint Lockout | Phase 14 | **CLOSED (PASS)** |
| **P1** | **RSK-005** | Telemetry Buffer Boundary Clamp | Phase 16 (Batch #1) | **CLOSED (PASS)** |
| **P1** | **RSK-007** | UART Error Callback Re-arm | Phase 16 (Batch #1) | **CLOSED (PASS)** |
| **P1** | **RSK-006** | DEGAS Mode Provisioning Interlock | Phase 16 (Batch #1) | **CLOSED (PASS)** |
| **P1** | **RSK-004** | ESP32 Master Response Blind Spot | Phase 16 (Batch #2) | **CLOSED (PASS)** |
| **P1** | **RSK-008** | Admin Command Authorization | Phase 16 (Batch #2) | **CLOSED (PASS)** |
| **P1** | **RSK-009** | RS485 Disconnect Stale UI Sync | Phase 16 (Batch #2) | **CLOSED (PASS)** |
| **P2** | **RSK-010 .. 013** | Minor Diagnostics / Calibration | Scheduled | **OPEN** |
| **P3** | **RSK-014 .. 015** | Cosmetic Telemetry Polishing | Scheduled | **OPEN** |

---

## 11. Final Risk Determination

| Risk ID | Title | Final Status | Evidence Level |
| :--- | :--- | :--- | :--- |
| **RSK-004** | ESP32 ACK/NACK/ERR Response Handling | **PASS** | Physical HIL + Mock Suite Verified |
| **RSK-008** | Service / Admin Command PIN Auth | **PASS** | Physical HIL + Mock Suite Verified |
| **RSK-009** | RS485 Disconnect Stale UI State Sync | **PASS** | Physical HIL + Mock Suite Verified |

---
*Report generated and validated under Phase 16: P1 Remediation Batch #2. Zero unrelated modules were modified.*
