erenerdemM/Ege_Eagle_Ultrasonik/docs/RSK008_DOCUMENTATION_RECONCILIATION_REPORT.md

# EAGLEULTRASONİK — RSK-008 SERVICE PIN DOCUMENTATION RECONCILIATION REPORT

---

## 1. Executive Summary

This report formalizes the complete documentation reconciliation of the **Service PIN** credential across all authoritative specification, architecture, and testing documents for the EAGLEULTRASONiK project.

Following the forensic audit in [`docs/RSK008_AUTHENTICATION_CONSISTENCY_REPORT.md`](file:///c:/Users/ern0e/EAGLEULTRASONiK/docs/RSK008_AUTHENTICATION_CONSISTENCY_REPORT.md), all legacy references to the obsolete 4-digit placeholder PIN `8888` have been replaced with the authoritative 6-digit production credential **`123456`** (`dogru_sifre = "123456"`).

```text
STATUS: RECONCILED & CONSISTENT (100% CODE-TO-DOCUMENTATION PARITY)
```

---

## 2. Distinction Between Production and Legacy Credentials

| Credential Type | Value | Length | Context / Purpose | Status |
| :--- | :--- | :--- | :--- | :--- |
| **Production Credential** | **`123456`** | 6 Digits | Hardcoded firmware variable `dogru_sifre = "123456"` in `ekran_kontrol.ino`, tested by `test_hil_uart.py` & `test_hmi_mock.py` | **ACTIVE & AUTHORITATIVE** |
| **Legacy Placeholder** | **`8888`** | 4 Digits | Early architecture specification placeholder in legacy markdown drafts | **OBSOLETE & RECONCILED** |

---

## 3. Authoritative Files Updated

| Document Path | Section(s) Updated | Previous Value | Reconciled Value |
| :--- | :--- | :--- | :--- |
| [`docs/EAGLEULTRASONIK_SYSTEM_MANIFESTO.md`](file:///c:/Users/ern0e/EAGLEULTRASONiK/docs/EAGLEULTRASONIK_SYSTEM_MANIFESTO.md) | §6 (ESP32), §7 (Nextion), §8 (Provisioning), §14 (Service) | `PIN 8888` | `Service PIN (123456)` |
| [`docs/SYSTEM_FUNCTION_INVENTORY.md`](file:///c:/Users/ern0e/EAGLEULTRASONiK/docs/SYSTEM_FUNCTION_INVENTORY.md) | Tree Item 5 & Detailed Section `ESP-SVC-AUTH` | `(8888)` | `(123456)` |
| [`docs/SYSTEM_MASTER_E2E_TEST_PLAN.md`](file:///c:/Users/ern0e/EAGLEULTRASONiK/docs/SYSTEM_MASTER_E2E_TEST_PLAN.md) | Test Matrix Row `ESP-SVC-AUTH` & `FLOW-02` Sequence | `PIN 8888` | `Service PIN 123456` |
| [`docs/SYSTEM_ALGORITHM_INTERACTION_AUDIT.md`](file:///c:/Users/ern0e/EAGLEULTRASONiK/docs/SYSTEM_ALGORITHM_INTERACTION_AUDIT.md) | Function 23 (`ID-ASSIGN`) Summary | `PIN 8888` | `Service PIN 123456` |
| [`docs/SYSTEM_PHASE7_REVIEW_REPORT.md`](file:///c:/Users/ern0e/EAGLEULTRASONiK/docs/SYSTEM_PHASE7_REVIEW_REPORT.md) | DEGAS Aspect A Table & Tank ID Provisioning Summary | `PIN 8888` | `Service PIN 123456` |
| [`docs/AGENT_OS_AUTONOMOUS_ORCHESTRATION_AUDIT.md`](file:///c:/Users/ern0e/EAGLEULTRASONiK/docs/AGENT_OS_AUTONOMOUS_ORCHESTRATION_AUDIT.md) | Section 5 (Child Results Received — `esp32-hmi-specialist`) | `PIN 8888` | `Service PIN 123456` |

---

## 4. Files Intentionally Preserved (Not Modified)

To maintain absolute code stability and zero test perturbation:
- **Production Firmware:** [`esp32/ekran_kontrol/ekran_kontrol.ino`](file:///c:/Users/ern0e/EAGLEULTRASONiK/esp32/ekran_kontrol/ekran_kontrol.ino) was **NOT modified**.
- **Mock Tests:** [`test_hmi_mock.py`](file:///c:/Users/ern0e/EAGLEULTRASONiK/test_hmi_mock.py) and [`test_rs485_mock.py`](file:///c:/Users/ern0e/EAGLEULTRASONiK/test_rs485_mock.py) were **NOT modified**.
- **Physical HIL Tests:** [`test_hil_uart.py`](file:///c:/Users/ern0e/EAGLEULTRASONiK/test_hil_uart.py) was **NOT modified**.
- **Historical Audit Context:** [`docs/RSK008_AUTHENTICATION_CONSISTENCY_REPORT.md`](file:///c:/Users/ern0e/EAGLEULTRASONiK/docs/RSK008_AUTHENTICATION_CONSISTENCY_REPORT.md) preserves historical reference to `8888` for forensic traceability.

---

## 5. Verification & Parity Confirmation

1. **Grep Repository Check:**
   - Search across all repository documentation confirms zero active specification or manifesto documents present `8888` as the current production PIN.
2. **Authentication Logic Parity:**
   - The 6-digit keypad entry, string comparison (`girilen_sifre == dogru_sifre`), `g_service_authenticated` session state flag, and 300-second inactivity timeout remain 100% untouched.
3. **RSK-008 Access Control:**
   - `isProvisioningAllowed()` guards on `P_SAVE|...`, `CMD_SET_STEP_INC:`, `CMD_SET_SWP_SPAN:`, and `CMD_SET_SWP_PER:` operate strictly against the authenticated service session unlocked via `123456`.

---

## 6. Final Status of RSK-008

```text
RSK-008 (Service / Admin Command Authorization):
  - Implementation: COMPLETE & VERIFIED (PASS)
  - Physical HIL Verification: 40/40 PASSED
  - Mock Suite Verification: 92/92 PASSED
  - Documentation Consistency: 100% RECONCILED
  - Overall Risk Status: CLOSED
```

---
*Report generated and approved under Phase 16 documentation reconciliation.*
