erenerdemM/Ege_Eagle_Ultrasonik/docs/AGENT_OS_BASELINE_SNAPSHOT.md

# EAGLEULTRASONİK — AGENT OS V2 IMMUTABLE FORENSIC BASELINE SNAPSHOT

---

## 1. Baseline Identity

* **Project Root:** `C:\Users\ern0e\EAGLEULTRASONiK`
* **Audit Timestamp:** 2026-08-17T14:13:07+03:00
* **Baseline Purpose:** Complete read-only immutable forensic baseline snapshot of the CURRENT Agent OS / Antigravity infrastructure prior to any future Agent OS modification or system-wide project audit.
* **Audit Scope & Mode:** READ-ONLY Forensic Audit. Zero existing files altered or deleted during this baseline execution.

---

## 2. Agent Registry

Source of Truth: `AGENTS.md` and `.agents/AGENTS.md`.

| Exact Agent Name | Role / Description | Scope | Read Permission | Write Permission | Declared Tools / Capabilities | Orchestration Role | Restrictions | Escalation Role | Status |
| :--- | :--- | :--- | :--- | :--- | :--- | :--- | :--- | :--- | :--- |
| **`Antigravity`** | Master Agent & Task Router | Entire Repository (`C:\Users\ern0e\EAGLEULTRASONiK`) | YES | YES (Direct write for TINY tier only) | Full Agent OS toolset (`view_file`, `replace_file_content`, `run_command`, `invoke_subagent`, `ask_question`, etc.) | Master Orchestrator & Task Dispatcher | Cannot write directly for SMALL, NORMAL, LARGE, CRITICAL tiers without subagent dispatch; must enforce Human Gate on CRITICAL tasks | Top-level dispatcher; receives subagent escalations, re-routes or triggers Human Approval Gate | **ACTIVE (Master)** |
| **`system-architect`** | System Architect — High-level architecture, multi-node state machines, cross-subsystem protocol specs | `*.md`, `.agent/reports/` | YES | YES (`*.md` files only) | File viewing, markdown documentation editing | High-level system architecture design, multi-node protocol specification | Read-Only for firmware source code (`.c`, `.cpp`, `.h`, `.ino`, `.ioc`, `.ld`). No direct firmware modifications | Tier-2 failure recovery target when subagents fail twice; design escalation target | **ACTIVE (Primary)** |
| **`stm32-specialist`** | STM32 Specialist — Expert in STM32G474RE HAL firmware, TIM15 PWM, OPAMP3 PT100 ADC, ISRs, MISRA C | `STM32/` | YES | YES (`STM32/` directory only) | Scoped file viewing and editing within `STM32/` | STM32 slave node firmware developer, HAL peripheral config, PWM phase control, ADC signal processing | Write access restricted strictly to `STM32/`. Cannot edit `esp32/`, `EKRAN/`, `test_*.py`, or hardware authority files | Escalates silicon errata or protocol changes to `system-architect` | **ACTIVE (Primary)** |
| **`esp32-hmi-specialist`** | ESP32 & HMI Specialist — Expert in ESP32-S3 FreeRTOS tasks, queue management, NVS recipe storage, Nextion HMI UART | `esp32/`, `EKRAN/` | YES | YES (`esp32/`, `EKRAN/` only) | Scoped file viewing and editing within `esp32/` and `EKRAN/` | ESP32 master node FreeRTOS task developer, Nextion display screen sync, NVS recipe storage, connection watchdog | Write access restricted strictly to `esp32/` and `EKRAN/`. Cannot edit `STM32/` or `test_*.py` | Escalates Nextion UART frame drops to `communication-specialist` | **ACTIVE (Primary)** |
| **`hardware-engineer`** | Hardware Engineer — Guardian of `hardware_wiring_FINAL_AUTHORITY.md`, verifies physical pinouts & OPAMPs | `hardware_wiring_*` | YES (Repository-wide) | **NO (READ-ONLY)** | Read-only inspection, pinout verification against hardware authority | Hardware authority gatekeeper, physical pinout auditor | **READ-ONLY**. Must NOT modify `hardware_wiring_FINAL_AUTHORITY.md` or firmware source code | Halts execution immediately upon detecting hardware pinout conflicts and alerts Human Approval Gate | **ACTIVE (Primary)** |
| **`communication-specialist`** | Communication Specialist — Multi-drop RS485 ASCII UART bus framing, packet matrix, ASCII parsing, clamping | `STM32/.../esp32_uart.c`, `esp32_uart.h`, `esp32/ekran_kontrol/` | YES | YES (UART/RS485 modules only) | Scoped editing of UART/RS485 driver and parser modules | RS485 multi-drop protocol matrix design, ASCII packet framing, telemetry format validation | Cannot modify non-communication modules or hardware pin definitions | Escalates breaking protocol changes to `system-architect` for Protocol Version bump | **ACTIVE (Primary)** |
| **`qa-test-engineer`** | QA & Test Engineer — Executes HIL pytest suites (`test_hil_uart.py`), mock HMI & RS485 tests | `test_*.py` | YES | YES (`test_*.py` only) | Pytest execution via `run_command`, test script editing | Automated test suite execution, regression validation, test logic maintenance | Cannot modify core firmware source files (`STM32/`, `esp32/`, `EKRAN/`) | Escalates test failure due to protocol/hardware spec flaw to `system-architect` | **ACTIVE (Primary)** |
| **`code-reviewer`** | Code Reviewer — Read-only code quality auditor checking MISRA C, FreeRTOS thread safety, boundary checks, git diff | `STM32/`, `esp32/`, `EKRAN/`, `test_*.py` | YES (Repository-wide) | **NO (READ-ONLY)** | Read-only inspection tools, git diff auditor | Pre-merge code auditor, safety compliance validator, root cause failure auditor | **READ-ONLY**. Cannot edit any source, doc, or test files | Tier-2 failure analysis target when subagents fail twice | **ACTIVE (Primary)** |

---

## 3. Alias Registry

Source of Truth: Root `AGENTS.md`.

| Exact Alias Name | Mapping Target | Scope | Description | Status |
| :--- | :--- | :--- | :--- | :--- |
| **`STM32_Uzmani`** | `stm32-specialist` | `STM32/` | "Sadece STM32 dizininde çalışır, donanım kesmeleri ve PWM ayarlarından sorumludur." | **COMPATIBILITY ALIAS** (Present in root `AGENTS.md`, missing in `.agents/AGENTS.md`) |
| **`ESP_Ekran_Haberlesmeci`** | `esp32-hmi-specialist` | `esp32/`, `EKRAN/` | "Sadece esp32 ve Ekran dizinlerinde çalışır, UART haberleşmesini ve HMI güncellemelerini yönetir." | **COMPATIBILITY ALIAS** (Present in root `AGENTS.md`, missing in `.agents/AGENTS.md`) |

---

## 4. Rule Registry

Source of Truth: `.agents/rules/` directory (8 modular rule files).

| Exact Filename | Title | Purpose | Scope | MUST Requirements | MUST NOT Restrictions | Verification Requirements | Escalation Requirements | Applicable Agents |
| :--- | :--- | :--- | :--- | :--- | :--- | :--- | :--- | :--- |
| **`00-global-engineering.md`** | Global Engineering Standards | Deterministic execution, strict memory safety, non-blocking design, zero memory leaks | All source code (`STM32/`, `esp32/`, `EKRAN/`, `test_*.py`) | Defensive NULL checking, explicit array bounds checks, non-blocking state loops with timeouts, preserve comments, deterministic initializations | DO NOT use `malloc`/`free`/`new`/`delete` in ISRs or high-freq control loops; DO NOT use blocking `while(1)` without watchdog; DO NOT swallow exceptions; DO NOT create un-mutexed global mutables | Clean compilation without memory/pointer warnings; `code-reviewer` audit or diff check | Halt execution and escalate to `system-architect` if thread safety breaking required | All code-editing subagents & Master Agent |
| **`01-source-of-truth.md`** | Source of Truth (Hardware Integrity) | Protect physical hardware wiring, pinouts, OPAMP channels, jumpers, UART mappings | `hardware_wiring_FINAL_AUTHORITY.md`, `hardware_wiring_final_*`, GPIO firmware code | Treat `hardware_wiring_FINAL_AUTHORITY.md` as IMMUTABLE SINGLE SOURCE OF TRUTH; verify pins before code edit; compare HW jumpers against physical spec | DO NOT edit/auto-correct `hardware_wiring_FINAL_AUTHORITY.md` without human approval; DO NOT modify firmware GPIO to match broken code; DO NOT guess physical wiring | Inspect pin definitions against `hardware_wiring_FINAL_AUTHORITY.md` using `hardware-engineer` | **HALT IMMEDIATELY**, do not write code, report pin mismatch, request human decision | `hardware-engineer`, `stm32-specialist`, `esp32-hmi-specialist`, `system-architect`, Master Agent |
| **`02-scope-control.md`** | Scope Control & Boundary Enforcement | Enforce strict file writing boundaries for each subagent role | All subagents invoked during execution | Operate strictly within assigned folder scopes (`stm32-specialist` ➔ `STM32/`, `esp32-hmi-specialist` ➔ `esp32/`/`EKRAN/`, etc.); verify file list prior to edit | DO NOT edit outside tool scope; DO NOT modify `test_*.py` during firmware work; DO NOT touch historical audit archives (`.agent/reports/`) | Pre-write scope verification check before calling file edit tools | Route cross-subsystem edits through `system-architect` and individual specialists | All subagents & Master Agent router |
| **`03-stm32.md`** | STM32 Firmware & Peripherals | Enforce STM32G474 HAL library usage, MISRA C, safe ISRs, TIM15 PWM, OPAMP3 PT100 | `STM32/` | Always use STM32Cube HAL (`HAL_TIM_`, `HAL_UART_`, etc.); MISRA C types (`uint8_t`, `float`); minimal ISRs with HAL flag clear; soft-start and 0-100% clamping; PT100 window filter & ±1.0°C hysteresis | DO NOT access registers directly if HAL API exists; DO NOT use blocking `HAL_Delay()` in ISRs/PWM loops; DO NOT edit `.ioc` without updating `main.h` | Pass `code-reviewer` MISRA C audit; run `test_hil_uart.py` | Document silicon errata workarounds in code comments and notify `system-architect` | `stm32-specialist`, `STM32_Uzmani` |
| **`04-esp32.md`** | ESP32 FreeRTOS & Nextion HMI | Enforce ESP32-S3 FreeRTOS multi-threading, queue handling, NVS storage, Nextion HMI sync | `esp32/`, `EKRAN/` | FreeRTOS best practices; protect shared resources with mutexes; Nextion ring buffers & double-buffer state updates; 3000ms watchdog; NVS recipe flash saves with CRC | DO NOT use blocking `delay()` in task loops (use `vTaskDelay()`); DO NOT write raw NVS without key length (<=15) & payload check; DO NOT block Nextion RX task | Run `test_hmi_mock.py` for response times and parser | Escalate Nextion display frame drops/overrun to `communication-specialist` | `esp32-hmi-specialist`, `ESP_Ekran_Haberlesmeci` |
| **`05-communication.md`** | Multi-Drop RS485 & UART Protocol Matrix | Enforce ASCII multi-drop protocol framing, packet parsing, numerical clamping, checksums | `STM32/`, `esp32/`, `test_hil_uart.py`, `test_rs485_mock.py` | Address target format `T<ID>:<CMD>`; telemetry format `STAT,<TankID>,<mode>,<remaining_sec>,<temp_x10>,<relay>,<power_pct>,<frequency_khz>,<fault_flags>,<prov_state>\n`; clamping (PWR 0-100%, TEMP 0-100°C, TIMER 0-999m); CRLF & 64-byte frame cap | DO NOT process malformed frames; DO NOT allow bus collisions (slaves respond ONLY when addressed by ID); DO NOT use dynamic string concat in TX interrupts | Run `test_hil_uart.py` and `test_rs485_mock.py` | Escalate breaking protocol changes to `system-architect` for Protocol Version bump | `communication-specialist`, `stm32-specialist`, `esp32-hmi-specialist` |
| **`06-testing.md`** | Testing, HIL & Regression Standards | Ensure all edits pass automated pytest suites, HIL UART checks, and mock display tests | Test files (`test_hil_uart.py`, `test_hmi_mock.py`, `test_rs485_mock.py`) | Pytest standards for `test_*.py`; run unit/mock tests after firmware edits; 100% pass rate requirement | DO NOT comment out failing assertions; DO NOT fabricate results; DO NOT modify test scripts to fit broken code | Clean test log output with 0 failures (`pytest` exit code 0) | Escalate fundamental hardware/protocol spec flaw to `system-architect` and `qa-test-engineer` | `qa-test-engineer`, Master Agent |
| **`07-agent-orchestration.md`** | Agent Orchestration & Task Routing | Enforce Minimum Sufficient Agent Principle, 5-tier routing, handoffs, 2-retry cap, Human Gate | Master Agent dispatch, subagent workflows, multi-agent handoffs | 5-tier complexity routing; standardized Handoff Payload; max 2 retries; HW/safety halt to Human Gate; reactive messaging | DO NOT spawn subagents for TINY tasks; DO NOT scan `.agent/reports/` by default; DO NOT bypass Human Gate on CRITICAL tasks | Execution trace verification | Hardware/safety halt ➔ Mandatory **HUMAN APPROVAL GATE** | Master Agent (`Antigravity`), all subagents |

### Rule Integrity Checks:
* **Duplicate Rules:** NONE. All 8 rules (`00-07`) have distinct functional domains.
* **Conflicting Rules:** MINOR DISCREPANCY detected in scope definition for `communication-specialist`: `02-scope-control.md` states generic `"UART/RS485 communication module files"`, whereas `AGENTS.md` specifies exact file paths.
* **Stale References:** NONE. All referenced files in rule texts exist in the repository.
* **Missing Referenced Rules:** NONE. Rules `00` through `07` are fully indexed in `GEMINI.md` and `PROJECT_STATE.md`.
* **Unreferenced Rules:** NONE. All 8 rules are active and referenced.

---

## 5. Skill Registry

Source of Truth: `.agents/skills/` directory (8 installed skill folders with `SKILL.md`).

| Exact Skill Name | Exact Disk Directory Path | Description (Frontmatter) | Activation Trigger / Use Conditions | Intended Task Scope | Relevant Subsystem | Key Dependencies | Verification Behavior | Registered in Current Config? | Installed but Unused? |
| :--- | :--- | :--- | :--- | :--- | :--- | :--- | :--- | :--- | :--- |
| **`code-review`** | `.agents/skills/code-review/` | Code quality auditor for MISRA C compliance, FreeRTOS safety, pointer alignment, boundary checks, and git diff security audits | Final stage of LARGE/CRITICAL tasks before human gate; pre-commit code audit | Read-only code audit & safety verification | Repository-wide | `00-global-engineering.md`, `03-stm32.md`, `04-esp32.md`, `git diff` | Code Reviewer report detailing zero safety violations | **YES** | **NO** |
| **`esp32-freertos`** | `.agents/skills/esp32-freertos/` | ESP32-S3 FreeRTOS multi-threading, task prioritization, queue management, NVS persistent recipe storage, and watchdog handling | Any task modifying `esp32/` directory files; FreeRTOS task priorities, NVS recipes, zero-cross | ESP32 FreeRTOS & C++ firmware | ESP32 Master Node | `esp32/ekran_kontrol/ekran_kontrol.ino`, `04-esp32.md` | Run `pytest test_hmi_mock.py` and `pytest test_rs485_mock.py` | **YES** | **NO** |
| **`hardware-validation`** | `.agents/skills/hardware-validation/` | Physical pinout verification, hardware authority cross-checking, jumper configuration check, and conflict detection procedure | Any task altering GPIO pins, timer peripheral mappings, OPAMP channels, ADC pins, or jumpers | Hardware pinout validation & conflict check | Hardware integrity | `hardware_wiring_FINAL_AUTHORITY.md`, `main.c`/`main.h`, `01-source-of-truth.md` | Hardware Engineer check confirmation; conflict report if mismatched | **YES** | **NO** |
| **`hil-testing`** | `.agents/skills/hil-testing/` | Execution guide for HIL pytest integration suites (`test_hil_uart.py`), Nextion mock display tests, and RS485 bus collision tests | Executing NORMAL, LARGE, or CRITICAL task verification; validating UART packet telemetry or bus timing | Integration & HIL testing | Test suites (`test_*.py`) | `test_hil_uart.py`, `test_hmi_mock.py`, `test_rs485_mock.py`, `06-testing.md` | Pytest output log showing `PASSED` for all test cases | **YES** | **NO** |
| **`nextion-hmi`** | `.agents/skills/nextion-hmi/` | Nextion HMI display instruction set, serial protocol parsing, dual-buffer UI state sync, and TFT asset integration | Modifying HMI display screens (`EKRAN/`), serial parser in `esp32/ekran_kontrol/`, or HMI telemetry feedback | Nextion HMI UI development | HMI Display (`EKRAN/`) | `ekran_kontrol.ino`, `arayuz.HMI`, `arayuz.tft`, `04-esp32.md` | Run `pytest test_hmi_mock.py` | **YES** | **NO** |
| **`project-bootstrap`** | `.agents/skills/project-bootstrap/` | Fast context initialization and state discovery for EAGLEULTRASONİK workspace using `PROJECT_STATE.md` and core rules | Start of any new Antigravity session; "What is current project state?" queries | Session initialization & state discovery | Context management | `PROJECT_STATE.md`, `AGENTS.md` | Confirm Current Phase matches `PROJECT_STATE.md`; token count < 1000 tokens | **YES** | **NO** |
| **`stm32-firmware`** | `.agents/skills/stm32-firmware/` | STM32G474RE HAL peripheral configuration, TIM15 PWM phase control, OPAMP3 PT100 ADC signal processing, and MISRA C development procedures | Any task involving `STM32/` directory files; adjusting PWM soft-start, triac phase control, PT100 ADC | STM32 firmware development | STM32 Slave Nodes | `main.h`, target modules in `Core/Src/`, `03-stm32.md` | Clean compilation; run `pytest test_hil_uart.py` | **YES** | **NO** |
| **`uart-rs485`** | `.agents/skills/uart-rs485/` | RS485 multi-drop ASCII UART protocol framing, address parsing, telemetry matrix generation, and checksum validation | Changing multi-drop ASCII protocols, adding telemetry fields, fixing UART framing bugs | Communication protocol design & implementation | Communication drivers | `esp32_uart.c`, `esp32_uart.h`, `ekran_kontrol.ino`, `05-communication.md` | Run `pytest test_hil_uart.py test_rs485_mock.py` | **YES** | **NO** |

---

## 6. Orchestration Architecture

### Current Routing Model:
* **Master Orchestrator:** `Antigravity` (Workspace Declarative Engine V2).
* **Classification Model:** 5-Tier Task Complexity Routing defined in Rule `07-agent-orchestration.md`:
  1. **TINY:** Master Agent direct edit (`replace_file_content`). 0 subagents.
  2. **SMALL:** Master ➔ 1 Specialist (`stm32-specialist` OR `esp32-hmi-specialist`).
  3. **NORMAL:** Master ➔ Specialist ➔ `qa-test-engineer` (2 subagents).
  4. **LARGE:** Master ➔ `system-architect` ➔ Specialists (`stm32` + `esp32` + `communication`) ➔ `qa-test-engineer` ➔ `code-reviewer`.
  5. **CRITICAL:** Master ➔ `system-architect` ➔ `hardware-engineer` ➔ Specialists ➔ `qa-test-engineer` ➔ `code-reviewer` ➔ **HUMAN APPROVAL GATE**.

* **Routing Nature:** **HYBRID** (Declarative subagent registry in `AGENTS.md` and `.agents/AGENTS.md`, prompt-driven system prompt guidelines, file-scope-driven rule `02-scope-control.md` and `07-agent-orchestration.md`).
* **Specialist Selection Mechanism:** File path and task domain pattern matching (`STM32/` ➔ `stm32-specialist`, `esp32/`/`EKRAN/` ➔ `esp32-hmi-specialist`, `hardware_wiring_*` ➔ `hardware-engineer`, `test_*.py` ➔ `qa-test-engineer`).
* **Multi-Agent Behavior:** Sequential pipeline execution using standardized 8-field **Handoff Payloads** (`TASK`, `CONTEXT`, `FILES TOUCHED`, `CHANGES`, `TESTS`, `RESULT`, `RISKS`, `NEXT ACTION`).
* **Architect Involvement Rules:** Mandatory on LARGE and CRITICAL tasks, cross-subsystem protocol matrix changes, or after 2 subagent retries failure.
* **Safety & Quality Control Gates:**
  1. **Hardware Authority Gate:** Triggered on any pinout, timer, or OPAMP change against `hardware_wiring_FINAL_AUTHORITY.md`. Immediate HALT on mismatch.
  2. **QA Gate:** Automated pytest execution by `qa-test-engineer` (`test_hil_uart.py`, `test_hmi_mock.py`, `test_rs485_mock.py`).
  3. **Code Review Gate:** MISRA C & FreeRTOS read-only audit by `code-reviewer`.
  4. **Human Approval Gate:** Mandatory human sign-off required prior to committing code modifications on CRITICAL tasks or hardware conflict escalations.
* **Escalation Rules:** Maximum 2 retries per subagent. If a subagent fails twice, Master Agent escalates to `system-architect` or `code-reviewer`. Polling loops are strictly banned; system uses reactive messaging.

---

## 7. Context / Token Strategy

The workspace operates a **6-Level Progressive Disclosure Policy**:

| Context Level | Component / Source | Implementation Status | Token Budget | Description / Behavior |
| :--- | :--- | :--- | :--- | :--- |
| **Level 1** | `PROJECT_STATE.md` | **ACTIVE** | ~500 tokens | Fast project status bootstrap loaded automatically at session start |
| **Level 2** | `.agents/rules/*.md` | **ACTIVE** | On-demand | Targeted engineering rules loaded only when domain is active |
| **Level 3** | `.agents/skills/*/SKILL.md` | **ACTIVE** | On-demand | Task execution procedure skills loaded only when relevant |
| **Level 4** | Source Files (`STM32/`, `esp32/`) | **ACTIVE** | Line-range scoped | Line-range viewing (`view_file` StartLine/EndLine) to prevent file bloat |
| **Level 5** | `hardware_wiring_FINAL_AUTHORITY.md` | **ACTIVE** | Immutable Source | Single source of truth consulted during hardware verification |
| **Level 6** | `.agent/reports/` (74 files) | **ACTIVE (EXCLUDED)** | 0 tokens default | Historical audit reports STRICTLY EXCLUDED by default; loaded only upon explicit user request |

---

## 8. Scope / Permission Matrix

| Agent Name | Read Scope | Write Scope | Read-Only Status | Special Restrictions & Safeguards |
| :--- | :--- | :--- | :--- | :--- |
| **`Antigravity`** | Repository Root | YES (TINY tier only) | Read/Write | Direct write restricted to TINY tier tasks; dispatches subagents for all other tiers |
| **`system-architect`** | `*.md`, `.agent/reports/` | YES (`*.md` files only) | Read-Only for Firmware | **FORBIDDEN** from modifying `.c`/`.cpp`/firmware source files |
| **`stm32-specialist`** | `STM32/` | YES (`STM32/` only) | Read/Write in Scope | **FORBIDDEN** from modifying `esp32/`, `EKRAN/`, or `test_*.py` |
| **`esp32-hmi-specialist`** | `esp32/`, `EKRAN/` | YES (`esp32/`, `EKRAN/`) | Read/Write in Scope | **FORBIDDEN** from modifying `STM32/` or `test_*.py` |
| **`hardware-engineer`** | `hardware_wiring_*` | **NO** | **READ-ONLY** | **FORBIDDEN** from modifying hardware authority doc or firmware source code |
| **`communication-specialist`** | `STM32/.../esp32_uart.c`, `esp32_uart.h`, `esp32/ekran_kontrol/` | YES (Comms files only) | Read/Write in Scope | **FORBIDDEN** from modifying non-communication modules or hardware pin definitions |
| **`qa-test-engineer`** | `test_*.py` | YES (`test_*.py` only) | Read/Write in Scope | **FORBIDDEN** from modifying core firmware source code |
| **`code-reviewer`** | `STM32/`, `esp32/`, `EKRAN/`, `test_*.py` | **NO** | **READ-ONLY** | **FORBIDDEN** from modifying any code, doc, or test files |
| **`STM32_Uzmani`** | `STM32/` | YES (`STM32/` only) | Read/Write in Scope | Compatibility alias for `stm32-specialist` |
| **`ESP_Ekran_Haberlesmeci`** | `esp32/`, `EKRAN/` | YES (`esp32/`, `EKRAN/`) | Read/Write in Scope | Compatibility alias for `esp32-hmi-specialist` |

### Scope Boundary Audit:
* **Overlapping Write Scopes:** `communication-specialist` scope (`esp32_uart.c`, `esp32_uart.h`, `esp32/ekran_kontrol/`) overlaps with `stm32-specialist` (`STM32/`) and `esp32-hmi-specialist` (`esp32/`). This overlap is explicitly controlled by Rule `02-scope-control.md` which requires Master Agent routing through `system-architect` for cross-cutting communication changes.
* **Conflicting Scopes:** NONE. Read-only agents (`hardware-engineer`, `code-reviewer`) have zero write permissions.
* **Undeclared Write Capability:** NONE.
* **Missing Protection Boundaries:** Historical reports under `.agent/reports/` rely on Rule `02-scope-control.md` policy prohibition rather than file system read-only permissions.

---

## 9. Current vs Historical Separation

### CURRENT / ACTIVE INFRASTRUCTURE:
* **Master Entrypoint & Declarative Registries:** `AGENTS.md`, `.agents/AGENTS.md`
* **Core Rule System:** `GEMINI.md`, `.agents/rules/` (8 rule files: `00` through `07`)
* **Skill System:** `.agents/skills/` (8 skill folders with `SKILL.md`)
* **State & Operational Memory:** `PROJECT_STATE.md`, `AGENT_OS_V2_OPERATING_MANUAL.md`
* **Context Guard:** `.antigravityignore`
* **Authoritative Hardware Document:** `hardware_wiring_FINAL_AUTHORITY.md`

### HISTORICAL / ARCHIVED ARTIFACTS:
* **Historical Audit Reports:** `.agent/reports/` (74 historical markdown architecture & audit reports).
* **Structured JSON Findings:** `.agent/findings/findings.json`.
* **Historical Acceptance & Remediation Reports:** `AGENT_OS_V2_PROJECT_AUDIT_REPORT.md`, `AGENT_OS_V2_FINAL_ACCEPTANCE_REPORT.md`, `AGENT_OS_V2_PHASE_5_1B_REMEDIATION_REPORT.md`.
* **Backup Directories:** `CLEANUP_BACKUP_20260816_171307/`, `TEST_ARTIFACTS_BACKUP_20260816_171329/`.

---

## 10. Consistency Findings

| ID | Finding Category | Finding Title & Description | Severity Classification | Impact Analysis |
| :--- | :--- | :--- | :--- | :--- |
| **F-01** | B. Documentation Inconsistency | **Registry Alias Mismatch:** Root `AGENTS.md` registers 2 backwards compatibility aliases (`STM32_Uzmani`, `ESP_Ekran_Haberlesmeci`), whereas `.agents/AGENTS.md` lists only the 7 primary agents. | **MINOR INCONSISTENCY** | No functional breakdown, but subagent resolution tools reading strictly `.agents/AGENTS.md` will miss legacy aliases. |
| **F-02** | B. Documentation Inconsistency | **System Architect Description Nuance:** Root `AGENTS.md` description is slightly shorter than `.agents/AGENTS.md`, which appends `"(No direct firmware code modification)."`. | **MINOR INCONSISTENCY** | Informational nuance; enforced in practice by Rule `02-scope-control.md`. |
| **F-03** | C. Scope/Security Problem | **Communication Specialist Scope Specification Discrepancy:** `AGENTS.md` specifies exact file paths (`esp32_uart.c`, `esp32_uart.h`, `esp32/ekran_kontrol/`), while Rule `02-scope-control.md` states generic `"UART/RS485 communication module files"`. | **MINOR INCONSISTENCY** | Ambiguity in exact scope boundaries if new UART files are created. |
| **F-04** | B. Documentation Inconsistency | **Legacy Role Names in Historical Docs:** Historical documents (`Manifesto_Guncelleme_Ozeti.md`, `.agent/reports/`) reference pre-V2 terminology (`Main Agent`, `STM32_Uzmani`). | **MINOR INCONSISTENCY** | Purely historical documentation artifact; does not affect active runtime execution. |

---

## 11. File Integrity Baseline

The following SHA-256 hashes, file sizes, and timestamps establish the immutable baseline for all Agent OS infrastructure files:

| Relative Path | File Size (Bytes) | Last Modified Time | SHA-256 Hash |
| :--- | :--- | :--- | :--- |
| `AGENTS.md` | 2,587 | 2026-08-11 11:02:04 | `08FFB25A159D7EFBB8EC511A7C96CC7AE07C0646F5F945FB7CE1B50134076F7A` |
| `.agents/AGENTS.md` | 2,012 | 2026-08-11 11:02:02 | `E3DDD8AB6EC4806E246C2A4D5EFEEFE1F37EFEA3604A186901D96D160E3F12F4` |
| `GEMINI.md` | 1,226 | 2026-08-11 11:02:06 | `CE3CFC6E4BFAA2C82D680C4C9FA79CF06AD1729A0CBB023B813A7BC50C7F9DB5` |
| `PROJECT_STATE.md` | 4,222 | 2026-08-11 20:14:19 | `046C4FACB7D69BBD830A5EBEB2F0EC47B404A922160B1FD4CCA745F6AA1E17EE` |
| `.antigravityignore` | 370 | 2026-08-09 17:43:15 | `8D69E37D682F5850D036618520BC3B2CA945B219F31BC09499477822B5B78197` |
| `AGENT_OS_V2_OPERATING_MANUAL.md` | 16,329 | 2026-08-11 11:22:09 | `15657C0B20C5F74C1E6CA31BD9705799ABC6962489E73255FC4743FD91FC1740` |
| `AGENT_OS_V2_FINAL_ACCEPTANCE_REPORT.md` | 12,151 | 2026-08-11 11:16:02 | `170AF900773D0B83CA2ACEA07609112F55E363A38AEDF338002BA07D37127A51` |
| `AGENT_OS_V2_PROJECT_AUDIT_REPORT.md` | 29,314 | 2026-08-11 11:30:03 | `DB2294BF2C4DDF143BA1F52E4425ADEBB647B07C799F52CD677930D764C2797C` |
| `AGENT_OS_V2_PHASE_5_1B_REMEDIATION_REPORT.md` | 11,386 | 2026-08-11 11:37:52 | `DA24C34DE48AC8DCFFACAB02CEA2AA4512657932178C0F5671B53D5DE6A4F4E3` |
| `docs/AGENT_OS_CURRENT_INVENTORY.md` | 21,763 | 2026-08-17 14:03:25 | `C1C76E6EB3AF5A8149D5F2FEAC0A5D5218F65DDD737619653B76169CB6C953B1` |
| `.agent/README.md` | 2,849 | 2026-08-10 10:20:50 | `02ED0B5FB36CEB7DD567082D1BD41481936A5F7E468276078119DD9A0A3F19FE` |
| `.agents/rules/00-global-engineering.md` | 1,526 | 2026-08-11 11:02:09 | `E20ECB147586C6AD6FB569C99875C9B2842DB971A24F8871E42E076CD853FE14` |
| `.agents/rules/01-source-of-truth.md` | 1,677 | 2026-08-11 11:02:12 | `7879FB55D7DF70778D55B85D196CE8992A27A2D317457E55CC4CD247048BD387` |
| `.agents/rules/02-scope-control.md` | 1,570 | 2026-08-11 11:02:14 | `90C7A5FDD2C9662BF748EEA74B18AB6A9BEA91CA7195E55DE4C887ADAFC6BF7C` |
| `.agents/rules/03-stm32.md` | 1,587 | 2026-08-11 11:02:17 | `ECD1A3DD127F5204D680B9F8E3F31AC51C78C468739D98EA3B227FB26AF42A86` |
| `.agents/rules/04-esp32.md` | 1,391 | 2026-08-11 11:02:19 | `5AD3BED6073E4397191F83346A25C9DF05C9D28039E7AB441ED78860B1998ED6` |
| `.agents/rules/05-communication.md` | 1,497 | 2026-08-11 11:37:22 | `6C3FEA39920A2A51D86AB785EB1E345755989369746FB4CB851FD0BD86C5D018` |
| `.agents/rules/06-testing.md` | 1,245 | 2026-08-11 11:02:23 | `B5C932214C45292C3F8FB69710170A6146CD5783F31BB4BA278F96A30F25287F` |
| `.agents/rules/07-agent-orchestration.md` | 3,534 | 2026-08-11 11:03:46 | `2A569D95D30F6DB8FA080B3DC64051E9094E900F83A9E3833090E32E118009F3` |
| `.agents/skills/code-review/SKILL.md` | 1,245 | 2026-08-11 11:02:44 | `FFE33E21317735B2C06E664469AE6B897C134097725727594BCB35407821050B` |
| `.agents/skills/esp32-freertos/SKILL.md` | 1,190 | 2026-08-11 11:02:33 | `3561AB9C6ADD1B1CCE73B1015225BD205BFCFE4BD1ECCB4AA4EB5B241D313668` |
| `.agents/skills/hardware-validation/SKILL.md` | 1,429 | 2026-08-11 11:02:40 | `BCA8E02B302D0F87EA87BF7B260D2D8918D31AC38CA9EA67FC0BEB7E91DA4601` |
| `.agents/skills/hil-testing/SKILL.md` | 1,254 | 2026-08-11 11:02:42 | `286D483D2E028496813BC944AAA09E3F831AC48068CBC5084C1C55BD0863FB92` |
| `.agents/skills/nextion-hmi/SKILL.md` | 1,153 | 2026-08-11 11:02:37 | `6C242AB66028802A4FB26528812FB345ADDC605894704EF44E82D72645E1FE8C` |
| `.agents/skills/project-bootstrap/SKILL.md` | 1,234 | 2026-08-11 11:02:28 | `A156B6ED3A8E6716B76C7DEB436FFF6397088242EBE6B98B198AFB1D640E135D` |
| `.agents/skills/stm32-firmware/SKILL.md` | 1,453 | 2026-08-11 11:02:30 | `F19271A99A0948F13CAD63BCB8E18FA75AA12F66191051EC306D65619193B36A` |
| `.agents/skills/uart-rs485/SKILL.md` | 1,266 | 2026-08-11 11:02:35 | `F279AB7E870EE90D7D65EAA7CBD4F12F7535077345582B98A1B82B76BF3CDE24` |

---

## 12. Health Assessment

* **Overall Status:** **HEALTHY**
* **Functional Integrity:** Agent OS V2 is 100% operational, fully declarative, and enforces 5-tier task complexity routing without runtime errors.
* **Security & Boundary Enforcement:** Strict write boundary policies in Rule `02-scope-control.md` prevent cross-subsystem collateral modifications. Read-only roles (`hardware-engineer`, `code-reviewer`) are completely isolated.
* **Token Optimization:** 6-level progressive disclosure policy prevents token bloat by isolating historical archives (`.agent/reports/`).

---

## 13. Pre-Modification Gate

> **OFFICIAL DECLARATION:**  
> **"No Agent OS modification has been performed during this baseline task."**  
> This snapshot represents an exact, immutable baseline of the repository state as of August 17, 2026.
