erenerdemM/Ege_Eagle_Ultrasonik/docs/AGENT_OS_RUNTIME_DELEGATION_AUDIT.md

# EAGLEULTRASONİK — AGENT OS RUNTIME SUBAGENT DELEGATION AUDIT

---

## 1. Executive Summary

This document presents the strict runtime subagent delegation audit for the EAGLEULTRASONiK Agent OS operating within Google Antigravity (AGY).

The audit evaluated whether the environment possesses actual runtime capabilities to dynamically define, instantiate, invoke, and receive results from child specialist agents, or whether agent routing operates purely as a static prompt convention within a single master conversation.

### Final Audit Verdict:
```text
RUNTIME SUBAGENT DELEGATION — VERIFIED
```

* **Actual Runtime Subagent Capability:** **AVAILABLE & OPERATIONAL** (Powered by `define_subagent`, `invoke_subagent`, `send_message`, and `manage_subagents` tools).
* **Number of Child Subagents Instantiated & Invoked:** **4** (`stm32-specialist`, `esp32-hmi-specialist`, `communication-specialist`, `qa-test-engineer`).
* **Number of Child Results Received:** **4** (100% independent generation and delivery to master context).
* **Orchestration Model:** **Model A (Real Subagent Runtime Delegation)**.

---

## 2. Declared Agent Inventory

The declarative agent registry defined in `AGENTS.md`, `.agents/AGENTS.md`, and `.agents/rules/07-agent-orchestration.md` specifies 7 primary specialist roles and 2 backward-compatibility aliases:

1. **`system-architect`:** High-level multi-node state machine and protocol specification.
2. **`stm32-specialist`:** STM32G474RE HAL firmware, TIM15 PWM generation, OPAMP3 PT100 ADC signal processing.
3. **`esp32-hmi-specialist`:** ESP32-S3 FreeRTOS tasks, NVS recipe storage, Nextion HMI UART parser.
4. **`hardware-engineer`:** Physical pinout verification, OPAMP channels, jumper configurations.
5. **`communication-specialist`:** RS485 multi-drop ASCII UART bus framing, command matrix, clamping rules.
6. **`qa-test-engineer`:** HIL pytest suites (`test_hil_uart.py`), mock HMI and RS485 test execution.
7. **`code-reviewer`:** Code quality auditor, MISRA C compliance, FreeRTOS thread safety auditor.
8. **Compatibility Aliases:** `STM32_Uzmani` (mapped to `stm32-specialist`) and `ESP_Ekran_Haberlesmeci` (mapped to `esp32-hmi-specialist`).

---

## 3. Runtime Delegation Capability

The audit confirmed that Antigravity provides native tool primitives for dynamic subagent instantiation and asynchronous execution:

* **`define_subagent`:** Dynamically registers new subagent types with specific names, descriptions, system prompts, and tool permissions (`enable_write_tools`, `enable_subagent_tools`, `enable_mcp_tools`).
* **`invoke_subagent`:** Asynchronously launches one or more subagents in parallel background conversation workspaces.
* **`send_message`:** Enables bi-directional inter-agent message passing between subagents and the master agent.
* **`manage_subagents`:** Tracks subagent lifecycle states (`running`, `idle`, `waiting_for_input`, `errored`) and permits explicit session management or termination (`list`, `kill`, `kill_all`).

---

## 4. Actual Subagent Execution Evidence

Four runtime delegation tests were executed concurrently in isolated subagent sessions. Below is the empirical evidence:

### TEST-RUNTIME-01: `stm32-specialist` Subagent Execution
* **Subagent Type Name:** `stm32-specialist`
* **Conversation ID:** `744fbf66-bae7-42a6-8f87-116555110f43`
* **Transcript Log URI:** [`file:///C:/Users/ern0e/.gemini/antigravity/brain/744fbf66-bae7-42a6-8f87-116555110f43/.system_generated/logs/transcript.jsonl`](file:///C:/Users/ern0e/.gemini/antigravity/brain/744fbf66-bae7-42a6-8f87-116555110f43/.system_generated/logs/transcript.jsonl)
* **Assigned Task:** Inspect one harmless STM32 source symbol in the `STM32/` directory and return file path, symbol name, and explanation.
* **Tools Executed by Subagent:** `list_dir: List STM32 directory`, `view_file: View ultrasonic_pwm.h`.
* **Received Result Payload:**
  ```text
  1. File Path: STM32/Ultrasonik_G4_Master/Core/Inc/ultrasonic_pwm.h (Line 25)
  2. Symbol Name: UltrasonicPWM_Init
  3. Explanation: UltrasonicPWM_Init initializes the triac gate GPIO pin, PC7 zero-cross EXTI input line, and TIM15 peripheral in one-pulse mode to configure triac phase-angle power control for the ultrasonic driver stage.
  ```
* **Execution Status:** **PASSED**

---

### TEST-RUNTIME-02: `esp32-hmi-specialist` Subagent Execution
* **Subagent Type Name:** `esp32-hmi-specialist`
* **Conversation ID:** `f55f8037-b6f6-4c4d-8c3f-0859edf57a28`
* **Transcript Log URI:** [`file:///C:/Users/ern0e/.gemini/antigravity/brain/f55f8037-b6f6-4c4d-8c3f-0859edf57a28/.system_generated/logs/transcript.jsonl`](file:///C:/Users/ern0e/.gemini/antigravity/brain/f55f8037-b6f6-4c4d-8c3f-0859edf57a28/.system_generated/logs/transcript.jsonl)
* **Assigned Task:** Inspect one harmless ESP32/HMI symbol in `esp32/` and return file path, symbol, and explanation.
* **Tools Executed by Subagent:** `list_dir: List contents of workspace root`, `list_dir: List esp32/ekran_kontrol`, `view_file: View ekran_kontrol.ino`.
* **Received Result Payload:**
  ```text
  1. File path: esp32/ekran_kontrol/ekran_kontrol.ino
  2. Symbol name: BusDiagnostics
  3. Explanation: BusDiagnostics is a structure that stores UART/RS485 communication metrics such as valid frame counts, CRC error counts, timeouts, and transmission statistics for the ESP32 controller.
  ```
* **Execution Status:** **PASSED**

---

### TEST-RUNTIME-03: `communication-specialist` Subagent Execution
* **Subagent Type Name:** `communication-specialist`
* **Conversation ID:** `512661ad-b60a-49a5-a013-22c085874357`
* **Transcript Log URI:** [`file:///C:/Users/ern0e/.gemini/antigravity/brain/512661ad-b60a-49a5-a013-22c085874357/.system_generated/logs/transcript.jsonl`](file:///C:/Users/ern0e/.gemini/antigravity/brain/512661ad-b60a-49a5-a013-22c085874357/.system_generated/logs/transcript.jsonl)
* **Assigned Task:** Inspect RS485 command framing in `esp32_uart.c` and return file path and framing observations.
* **Tools Executed by Subagent:** `view_file: View esp32_uart.c`, `send_message: Send findings to parent`.
* **Received Result Payload:**
  ```text
  1. Source File Path: STM32/Ultrasonik_G4_Master/Core/Src/esp32_uart.c
  2. Framing Observations:
     - Line Termination: \n terminated ASCII text (optional \r stripped), 64-byte RX buffer cap.
     - Multi-Drop Addressing: Prefix T<id>: parsed. T0: recognized as universal broadcast. Non-matching slave IDs ignored.
     - RS485 Direction Control: Half-duplex PB1 GPIO control via RS485_TX_ENABLE() / RS485_RX_ENABLE().
  ```
* **Execution Status:** **PASSED**

---

### TEST-RUNTIME-04: `qa-test-engineer` Subagent Execution
* **Subagent Type Name:** `qa-test-engineer`
* **Conversation ID:** `3a63238e-060b-44db-8c8e-d7cb12597ed5`
* **Transcript Log URI:** [`file:///C:/Users/ern0e/.gemini/antigravity/brain/3a63238e-060b-44db-8c8e-d7cb12597ed5/.system_generated/logs/transcript.jsonl`](file:///C:/Users/ern0e/.gemini/antigravity/brain/3a63238e-060b-44db-8c8e-d7cb12597ed5/.system_generated/logs/transcript.jsonl)
* **Assigned Task:** Inspect one test in `test_hil_uart.py` and return test name, purpose, and mock/HIL status.
* **Tools Executed by Subagent:** `view_file: View test_hil_uart.py`.
* **Received Result Payload:**
  ```text
  1. Test Function Name: test_16_safety_watchdog_comm_loss (Line 726)
  2. Purpose: Verifies that STM32 triggers a safety watchdog shutdown upon RS485 comm loss (>3000ms silence).
  3. Mock vs. Physical HIL: Physical HIL (interacts directly with bench hardware over USB-serial ports).
  ```
* **Execution Status:** **PASSED**

---
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
