erenerdemM/Ege_Eagle_Ultrasonik/docs/AGENT_OS_CURRENT_INVENTORY.md

# EAGLEULTRASONİK — AGENT OS V2 CURRENT INFRASTRUCTURE FORENSIC INVENTORY

**Audit Date:** August 17, 2026  
**Scope:** `C:\Users\ern0e\EAGLEULTRASONiK`  
**Status:** Read-Only Forensic Audit Completed  
**Agent OS Version:** 2.0.0 (Workspace Declarative Engine)  

---

## 1. Executive Summary

A comprehensive read-only forensic audit was performed on the Agent OS / Antigravity agent infrastructure installed in `C:\Users\ern0e\EAGLEULTRASONiK`. The system represents a fully declarative, 5-tier task-aware Agent OS (V2) architecture.

### Quantitative Summary:
* **Master Orchestrator:** 1 (`Antigravity`)
* **Primary Specialized Subagents:** 7 (`system-architect`, `stm32-specialist`, `esp32-hmi-specialist`, `hardware-engineer`, `communication-specialist`, `qa-test-engineer`, `code-reviewer`)
* **Backwards Compatibility Aliases:** 2 (`STM32_Uzmani`, `ESP_Ekran_Haberlesmeci`)
* **Total Declared Agent Registry Entries:** 9 (in root `AGENTS.md`)
* **Modular Engineering Rules:** 8 (in `.agents/rules/`)
* **Modular Skills:** 8 (in `.agents/skills/`)
* **Installed vs Activated Skills:** 8 installed / 8 active & registered / 0 unused
* **Orchestration Routing Tiers:** 5 (`TINY`, `SMALL`, `NORMAL`, `LARGE`, `CRITICAL`)
* **Safety & Control Gates:** 4 (Hardware Authority Gate, QA Gate, Code Review Gate, Human Approval Gate)
* **Historical Audit Reports Excluded:** 74 files (archived in `.agent/reports/`)

---

## 2. Agent Registry

| Exact Agent Name | Role / Description | Allowed File/Folder Scope | Read/Write Permission | Read-Only Status | Declared Tools / Capabilities | Orchestration Role | Parent / Master Relationship | Status |
| :--- | :--- | :--- | :--- | :--- | :--- | :--- | :--- | :--- |
| **`Antigravity`** | Master Agent & Task Router | Entire Repository | Read & Write (Direct write for TINY tasks only) | Read/Write | Full toolset (`view_file`, `replace_file_content`, `run_command`, `invoke_subagent`, `ask_question`, etc.) | Master Orchestrator | Self (Top-level agent) | **ACTIVE (Master)** |
| **`system-architect`** | System Architect — High-level architecture, multi-node state machines, cross-subsystem protocols | `*.md`, `.agent/reports/` | Write permitted ONLY in Markdown (`*.md`) | Read-Only for firmware code | Documentation editing, architecture analysis | High-level system design, protocol spec | Subagent of `Antigravity` | **ACTIVE (Primary)** |
| **`stm32-specialist`** | STM32 Specialist — Expert in STM32G474RE HAL firmware, TIM15 PWM, OPAMP3 PT100 ADC, ISRs, MISRA C | `STM32/` | Write permitted ONLY in `STM32/` | Read/Write in scope | Firmware modification, HAL driver config | STM32 node specialist | Subagent of `Antigravity` | **ACTIVE (Primary)** |
| **`esp32-hmi-specialist`** | ESP32 & HMI Specialist — Expert in ESP32-S3 FreeRTOS tasks, queues, NVS storage, Nextion HMI UART, C++ | `esp32/`, `EKRAN/` | Write permitted ONLY in `esp32/` & `EKRAN/` | Read/Write in scope | FreeRTOS task editing, HMI display sync | ESP32 & HMI specialist | Subagent of `Antigravity` | **ACTIVE (Primary)** |
| **`hardware-engineer`** | Hardware Engineer — Guardian of `hardware_wiring_FINAL_AUTHORITY.md`, verifies physical pinouts & OPAMPs | `hardware_wiring_*` | READ-ONLY repository-wide | **READ-ONLY** | Hardware conflict audit, pinout verification | Hardware Authority Guardian | Subagent of `Antigravity` | **ACTIVE (Primary)** |
| **`communication-specialist`** | Communication Specialist — Multi-drop RS485 ASCII UART bus framing, packet matrix, parsing, clamping | `STM32/.../esp32_uart.c`, `esp32_uart.h`, `esp32/ekran_kontrol/` | Write permitted ONLY in UART/RS485 modules | Read/Write in comms scope | Communication protocol & framing modification | Protocol & Bus specialist | Subagent of `Antigravity` | **ACTIVE (Primary)** |
| **`qa-test-engineer`** | QA & Test Engineer — Executes HIL pytest suites (`test_hil_uart.py`), mock HMI & RS485 tests | `test_*.py` | Write permitted ONLY in `test_*.py` | Read/Write in test scope | Pytest execution via `run_command`, test editing | Automated test & regression auditor | Subagent of `Antigravity` | **ACTIVE (Primary)** |
| **`code-reviewer`** | Code Reviewer — Read-only code quality auditor checking MISRA C, FreeRTOS safety, boundary checks, git diff | `STM32/`, `esp32/`, `EKRAN/`, `test_*.py` | READ-ONLY repository-wide | **READ-ONLY** | Code auditing, git diff inspection | Quality & Safety auditor | Subagent of `Antigravity` | **ACTIVE (Primary)** |
| **`STM32_Uzmani`** | STM32 Uzmanı (Turkish alias for legacy compatibility) | `STM32/` | Write permitted ONLY in `STM32/` | Read/Write in scope | Firmware modification | Legacy alias mapping to `stm32-specialist` | Subagent Alias | **COMPATIBILITY ALIAS** |
| **`ESP_Ekran_Haberlesmeci`**| ESP32 & Ekran Haberleşmeci (Turkish alias for legacy compatibility) | `esp32/`, `EKRAN/` | Write permitted ONLY in `esp32/` & `EKRAN/` | Read/Write in scope | FreeRTOS & UART modification | Legacy alias mapping to `esp32-hmi-specialist` | Subagent Alias | **COMPATIBILITY ALIAS** |

---

## 3. Rule Registry

All engineering rules are modularized under `.agents/rules/`:

| Filename | Title | Purpose | Scope | Key MUST Requirements | Key MUST NOT Restrictions | Verification Requirements | Escalation Rules | Target Agents / Tasks |
| :--- | :--- | :--- | :--- | :--- | :--- | :--- | :--- | :--- |
| **`00-global-engineering.md`** | Global Engineering Standards | Deterministic execution, strict memory safety, non-blocking design, 0 leaks | `STM32/`, `esp32/`, `EKRAN/`, `test_*.py` | Defensive NULL checks, explicit array bounds, non-blocking loops, preserve comments | NO `malloc`/`free`/`new`/`delete` in ISRs or control loops; NO `while(1)` without watchdog; NO swallowing exceptions | Clean compilation; `code-reviewer` audit or diff check | Halt & escalate to `system-architect` if thread safety breaking required | All agents editing code |
| **`01-source-of-truth.md`** | Source of Truth (Hardware Integrity) | Protect physical hardware wiring, pinouts, OPAMP channels, jumpers, UART maps | `hardware_wiring_FINAL_AUTHORITY.md`, `hardware_wiring_final_*`, GPIO code | Treat `hardware_wiring_FINAL_AUTHORITY.md` as IMMUTABLE SINGLE SOURCE OF TRUTH; verify pins before code edit | DO NOT edit HW authority doc without human approval; DO NOT change GPIO code to fit broken logic | Inspect pins via `hardware-engineer` | **HALT IMMEDIATELY**, do not write code, report pin mismatch, request human decision | `hardware-engineer`, `stm32-specialist`, `esp32-hmi-specialist`, `system-architect` |
| **`02-scope-control.md`** | Scope Control & Boundary Enforcement | Enforce strict file writing boundaries for each subagent role | All subagents invoked during execution | Agents operate strictly within assigned folder scopes; verify file list prior to edit | DO NOT edit outside tool scope; DO NOT touch test scripts during firmware work; DO NOT edit `.agent/reports/` | Pre-write scope verification check | Cross-subsystem edits must be routed through `system-architect` and individual specialists | All subagents & Master Agent router |
| **`03-stm32.md`** | STM32 Firmware & Peripherals | Enforce STM32G474 HAL usage, MISRA C, safe ISRs, TIM15 PWM, OPAMP3 PT100 | `STM32/` | Always use STM32Cube HAL; MISRA C types (`uint8_t`, `float`); minimal ISRs; soft-start & 0-100% clamping; PT100 moving avg | NO direct register access if HAL exists; NO `HAL_Delay()` in ISRs/PWM loops; NO `.ioc` edit without updating `main.h` | Pass `code-reviewer` MISRA C audit; run `test_hil_uart.py` | Document silicon workarounds in code comments and notify `system-architect` | `stm32-specialist`, `STM32_Uzmani` |
| **`04-esp32.md`** | ESP32 FreeRTOS & Nextion HMI | Enforce FreeRTOS multi-threading, queue handling, NVS recipe storage, 3000ms watchdog | `esp32/`, `EKRAN/` | FreeRTOS best practices; protect shared resources with mutexes; Nextion ring buffers; 3000ms connection watchdog; NVS CRC | NO blocking `delay()` in task loops (use `vTaskDelay()`); NO raw NVS write without key length (<=15) check; NO blocking RX task | Run `test_hmi_mock.py` for response times and parser | Escalate to `communication-specialist` if Nextion display suffers frame drops | `esp32-hmi-specialist`, `ESP_Ekran_Haberlesmeci` |
| **`05-communication.md`** | Multi-Drop RS485 & UART Protocol Matrix | Enforce ASCII multi-drop protocol framing, packet parsing, numerical clamping, checksums | `STM32/`, `esp32/`, `test_hil_uart.py`, `test_rs485_mock.py` | Enforce `T<ID>:<CMD>` target format; `STAT,...` telemetry format; clamping (PWR 0-100%, TEMP 0-100°C, TIMER 0-999m); CRLF termination | DO NOT process malformed frames; DO NOT allow bus collisions (slaves respond ONLY when addressed); NO string concat in ISR | Run `test_hil_uart.py` and `test_rs485_mock.py` | Escalate to `system-architect` for Protocol Version bump if packet format changes | `communication-specialist`, `stm32-specialist`, `esp32-hmi-specialist` |
| **`06-testing.md`** | Testing, HIL & Regression Standards | Ensure all edits pass automated pytest suites, HIL UART checks, and mock display tests | Test files (`test_hil_uart.py`, `test_hmi_mock.py`, `test_rs485_mock.py`) | Pytest standards for `test_*.py`; run unit/mock tests after firmware edits; 100% pass rate requirement | DO NOT comment out failing assertions; DO NOT fabricate results; DO NOT modify tests to fit broken code | Clean test log output with 0 failures (`pytest` exit code 0) | Escalate to `system-architect` and `qa-test-engineer` if spec flaw revealed | `qa-test-engineer`, Master Agent |
| **`07-agent-orchestration.md`**| Agent Orchestration & Task Routing | Enforce Minimum Sufficient Agent Principle, 5-tier routing, handoffs, 2-retry cap, Human Gate | Master Agent dispatch, subagent workflows, multi-agent handoffs | 5-tier complexity routing; standardized Handoff Payload; max 2 retries; HW/safety halt to Human Gate; reactive messaging | DO NOT spawn subagents for TINY tasks; DO NOT scan `.agent/reports/` by default; DO NOT bypass Human Gate on CRITICAL | Execution trace verification | Hardware/safety halt -> Mandatory **HUMAN APPROVAL GATE** | Master Agent (`Antigravity`), all subagents |

---

## 4. Skill Registry

All skills reside under `.agents/skills/<skill-name>/SKILL.md`:

| Exact Skill Name | Exact Disk Path | Description / Frontmatter | Activation Trigger / Use Conditions | Intended Task Types | Relevant Subsystem | Key Dependencies | Verification Instructions | Router Status |
| :--- | :--- | :--- | :--- | :--- | :--- | :--- | :--- | :--- |
| **`code-review`** | `.agents/skills/code-review/SKILL.md` | Code quality auditor for MISRA C compliance, FreeRTOS safety, pointer alignment, git diff | Final stage of LARGE/CRITICAL tasks before human approval gate; pre-commit audit | Code audit & security verification | Repository-wide | `00-global-engineering.md`, `03-stm32.md`, `04-esp32.md`, `git diff` | Code Reviewer report detailing zero safety violations | **ACTIVELY REGISTERED** |
| **`esp32-freertos`** | `.agents/skills/esp32-freertos/SKILL.md` | ESP32-S3 FreeRTOS multi-threading, task prioritization, queue management, NVS recipe storage | Any task modifying `esp32/` directory files; task priorities, NVS recipes, zero-cross | ESP32 FreeRTOS & C++ firmware | ESP32 Master Node | `esp32/ekran_kontrol/ekran_kontrol.ino`, `04-esp32.md` | Run `pytest test_hmi_mock.py` and `pytest test_rs485_mock.py` | **ACTIVELY REGISTERED** |
| **`hardware-validation`** | `.agents/skills/hardware-validation/SKILL.md` | Physical pinout verification, hardware authority cross-checking, jumper configuration check | Any task altering GPIO pins, timers, OPAMP channels, ADC pins, or jumpers | Hardware pinout validation & conflict check | Hardware integrity | `hardware_wiring_FINAL_AUTHORITY.md`, `main.c`/`main.h`, `01-source-of-truth.md` | Hardware Engineer check confirmation | **ACTIVELY REGISTERED** |
| **`hil-testing`** | `.agents/skills/hil-testing/SKILL.md` | Execution guide for HIL pytest integration suites (`test_hil_uart.py`), Nextion mock display | Verification of NORMAL, LARGE, or CRITICAL tasks; UART packet telemetry, Nextion UI | Integration & HIL testing | Test suites (`test_*.py`) | `test_hil_uart.py`, `test_hmi_mock.py`, `test_rs485_mock.py`, `06-testing.md` | Pytest output log showing `PASSED` for all test cases | **ACTIVELY REGISTERED** |
| **`nextion-hmi`** | `.agents/skills/nextion-hmi/SKILL.md` | Nextion HMI display instruction set, serial protocol parsing, dual-buffer UI state sync | Modifying HMI display screens (`EKRAN/`), serial parser in `esp32/ekran_kontrol/` | Nextion HMI UI development | HMI Display (`EKRAN/`) | `ekran_kontrol.ino`, `arayuz.HMI`, `arayuz.tft`, `04-esp32.md` | Run `pytest test_hmi_mock.py` | **ACTIVELY REGISTERED** |
| **`project-bootstrap`** | `.agents/skills/project-bootstrap/SKILL.md` | Fast context initialization and state discovery for EAGLEULTRASONİK using `PROJECT_STATE.md` | Start of any new Antigravity session; "What is current state?" query | Session initialization & state discovery | Context management | `PROJECT_STATE.md`, `AGENTS.md` | Confirm Current Phase matches `PROJECT_STATE.md`; token count < 1000 | **ACTIVELY REGISTERED** |
| **`stm32-firmware`** | `.agents/skills/stm32-firmware/SKILL.md` | STM32G474RE HAL peripheral configuration, TIM15 PWM phase control, OPAMP3 PT100 ADC | Any task involving `STM32/` directory files; PWM soft-start, triac phase control, PT100 ADC | STM32 firmware development | STM32 Slave Nodes | `main.h`, target modules in `Core/Src/`, `03-stm32.md` | Clean compilation; run `pytest test_hil_uart.py` | **ACTIVELY REGISTERED** |
| **`uart-rs485`** | `.agents/skills/uart-rs485/SKILL.md` | RS485 multi-drop ASCII UART protocol framing, address parsing, telemetry matrix, checksums | Changing multi-drop ASCII protocols, adding telemetry fields, fixing framing bugs | Communication protocol design & implementation | Communication drivers | `esp32_uart.c`, `esp32_uart.h`, `ekran_kontrol.ino`, `05-communication.md` | Run `pytest test_hil_uart.py test_rs485_mock.py` | **ACTIVELY REGISTERED** |

### Skill Categorization Breakdown:
* **Installed Skills:** 8 skills physically present in `.agents/skills/`
* **Referenced/Registered Skills:** 8 skills registered in `PROJECT_STATE.md`, `AGENT_OS_V2_OPERATING_MANUAL.md`, and system prompt
* **Actually Activated Skills:** 8 skills dynamically loaded on demand based on task domain
* **Unused / Orphan Skills:** 0 skills

---

## 5. Orchestration Architecture

### Current Routing Flow:
1. **Master Orchestrator:** `Antigravity` serves as the top-level dispatch router.
2. **Task Classification (5 Tiers):**
   * **TINY:** Direct edit by `Antigravity` (0 subagents).
   * **SMALL:** Direct dispatch to 1 Specialist (`stm32-specialist` OR `esp32-hmi-specialist`).
   * **NORMAL:** Pipeline of 2 Subagents (`Specialist` ➔ `qa-test-engineer`).
   * **LARGE:** Multi-agent pipeline (`system-architect` ➔ `Specialists` ➔ `qa-test-engineer` ➔ `code-reviewer`).
   * **CRITICAL:** Full pipeline (`system-architect` ➔ `hardware-engineer` ➔ `Specialists` ➔ `qa-test-engineer` ➔ `code-reviewer` ➔ **HUMAN APPROVAL GATE**).
3. **Cross-Subsystem Protocol:** When a task touches both STM32 and ESP32, Master routes through `system-architect` to produce a spec, then invokes `stm32-specialist` and `esp32-hmi-specialist` in isolation within their folder scopes using standardized **Handoff Payloads**.
4. **Mandatory Gates:**
   * **Hardware Authority Gate:** Triggered on any pin, jumper, or OPAMP change against `hardware_wiring_FINAL_AUTHORITY.md`. Conflict causes immediate HALT.
   * **QA Gate:** Automated pytest execution by `qa-test-engineer` (`test_hil_uart.py`, `test_hmi_mock.py`, `test_rs485_mock.py`).
   * **Code Review Gate:** MISRA C & FreeRTOS read-only audit by `code-reviewer`.
   * **Human Approval Gate:** Mandatory sign-off required prior to committing code modifications on CRITICAL tasks or hardware conflict escalations.
5. **Failure Recovery:** Maximum 2 retries per subagent. If a subagent fails twice, Master escalates to `system-architect` or `code-reviewer`. Polling loops are banned (reactive messaging used).

---

## 6. Context / Token Strategy

The workspace operates a **6-Level Progressive Disclosure Policy**:

| Context Level | Component / Source | Implementation Status | Token Target | Description |
| :--- | :--- | :--- | :--- | :--- |
| **Level 1** | `PROJECT_STATE.md` | **CURRENT** | ~500 tokens | Immediate status bootstrap loaded at session start |
| **Level 2** | `.agents/rules/*.md` | **CURRENT** | On-demand | Targeted engineering rules loaded only when domain is active |
| **Level 3** | `.agents/skills/*/SKILL.md` | **CURRENT** | On-demand | Task execution procedure skills loaded only when relevant |
| **Level 4** | Source Code (`STM32/`, `esp32/`) | **CURRENT** | Line-range scoped | Line-range viewing (`view_file` StartLine/EndLine) |
| **Level 5** | `hardware_wiring_FINAL_AUTHORITY.md` | **CURRENT** | Immutable Source | Single source of truth consulted during hardware verification |
| **Level 6** | `.agent/reports/` (74 files) | **CURRENT (EXCLUDED)** | 0 tokens default | Historical audit reports BANNED by default; loaded strictly on explicit user request |

---

## 7. Scope / Permission Matrix

| Agent Name | Declared Folder Scope | Read Permission | Write Permission | Scope Restrictions & Safeguards |
| :--- | :--- | :--- | :--- | :--- |
| **`Antigravity`** | Repository Root | YES | YES (TINY only) | Direct edits restricted to TINY tasks; dispatches subagents for all other tiers |
| **`system-architect`** | `*.md`, `.agent/reports/` | YES | YES (`*.md` only) | **FORBIDDEN** from modifying `.c`/`.cpp`/firmware source files |
| **`stm32-specialist`** | `STM32/` | YES | YES (`STM32/` only) | **FORBIDDEN** from modifying `esp32/`, `EKRAN/`, or `test_*.py` |
| **`esp32-hmi-specialist`** | `esp32/`, `EKRAN/` | YES | YES (`esp32/`, `EKRAN/`) | **FORBIDDEN** from modifying `STM32/` or `test_*.py` |
| **`hardware-engineer`** | `hardware_wiring_*` | YES | **NO (READ-ONLY)**| **FORBIDDEN** from modifying hardware authority doc or firmware source |
| **`communication-specialist`** | `STM32/.../esp32_uart.c`, `esp32_uart.h`, `esp32/ekran_kontrol/` | YES | YES (Comms modules) | **FORBIDDEN** from modifying pin definitions or non-comm modules |
| **`qa-test-engineer`** | `test_*.py` | YES | YES (`test_*.py` only)| **FORBIDDEN** from modifying core firmware source code |
| **`code-reviewer`** | `STM32/`, `esp32/`, `EKRAN/`, `test_*.py` | YES | **NO (READ-ONLY)**| **FORBIDDEN** from modifying any code, doc, or test files |

---

## 8. Consistency Audit

The forensic audit identified 4 minor structural inconsistencies between agent configuration files:

1. **Root `AGENTS.md` vs `.agents/AGENTS.md` Backwards Compatibility Aliases:**
   * Root `AGENTS.md` contains 2 legacy compatibility aliases (`STM32_Uzmani` and `ESP_Ekran_Haberlesmeci`).
   * `.agents/AGENTS.md` lists only the 7 primary subagents and omits the 2 alias entries.
2. **`system-architect` Description Nuance:**
   * Root `AGENTS.md` description: `"System Architect — High-level architecture, multi-node state machines, and cross-subsystem protocol specifications."`
   * `.agents/AGENTS.md` description adds explicit restriction: `"(No direct firmware code modification)."`
3. **Communication Specialist Scope Definition Discrepancy:**
   * `AGENTS.md` & `.agents/AGENTS.md` specify exact files: `STM32/Ultrasonik_G4_Master/Core/Src/esp32_uart.c`, `STM32/Ultrasonik_G4_Master/Core/Inc/esp32_uart.h`, `esp32/ekran_kontrol/`.
   * `02-scope-control.md` specifies broad folder boundary: `"UART/RS485 communication module files"`.
4. **Legacy Agent Names in Historical Documentation:**
   * `Manifesto_Guncelleme_Ozeti.md` references pre-V2 names (`Main Agent`, `STM32_Uzmani`, `ESP_Ekran_Haberlesmeci`).

---

## 9. Current vs Historical Separation

### CURRENTLY INSTALLED / ACTIVE:
* **Declarative Master & Agent Definitions:** `AGENTS.md`, `.agents/AGENTS.md`
* **Core Rules Index:** `GEMINI.md`, `.agents/rules/*.md` (8 rule files)
* **Skills Directory:** `.agents/skills/*` (8 skill folders with `SKILL.md`)
* **State & Operational Memory:** `PROJECT_STATE.md`, `AGENT_OS_V2_OPERATING_MANUAL.md`
* **Context Guard:** `.antigravityignore`
* **Authoritative Hardware Document:** `hardware_wiring_FINAL_AUTHORITY.md`

### HISTORICAL / ARCHIVED / OBSOLETE:
* **`.agent/reports/`:** 74 historical architecture and audit reports from Phase 4.5 through Phase 5.2.
* **`.agent/findings/findings.json`:** JSON audit findings from past automated runs.
* **`AGENT_OS_V2_PROJECT_AUDIT_REPORT.md`:** Historical audit report from Agent OS V2 initialization.
* **`AGENT_OS_V2_FINAL_ACCEPTANCE_REPORT.md`:** Historical acceptance validation report.
* **`AGENT_OS_V2_PHASE_5_1B_REMEDIATION_REPORT.md`:** Historical remediation report.
* **Backup Directories:** `CLEANUP_BACKUP_20260816_171307/`, `TEST_ARTIFACTS_BACKUP_20260816_171329/`.

---

## 10. Recommendations

1. **Synchronize `AGENTS.md` and `.agents/AGENTS.md`:** Standardize the 2 compatibility aliases (`STM32_Uzmani`, `ESP_Ekran_Haberlesmeci`) across both registry files to prevent lookup mismatches.
2. **Align Communication Specialist Scope Syntax:** Clarify `02-scope-control.md` to reference exact communication file paths matching `.agents/AGENTS.md`.
3. **Keep Level 6 Historical Exclusion Strict:** Maintain the default ban on loading `.agent/reports/` (74 files) during normal tasks to preserve token efficiency.
4. **Proceed to Manifesto & Coverage Audit:** The Agent OS infrastructure is fully healthy, coherent, and ready for system-wide manifesto coverage auditing.
