erenerdemM/Ege_Eagle_Ultrasonik/docs/C_SWEEP_FINAL_VERIFICATION_REPORT.md

# EAGLEULTRASONİK — Frequency Sweep / Shifting Final Verification Report

> **Document Status:** Final Verification & Acceptance Report  
> **Authoritative Baseline Documents:**  
> - [`docs/C_SWEEP_REQUIREMENTS.md`](file:///c:/Users/ern0e/EAGLEULTRASONiK/docs/C_SWEEP_REQUIREMENTS.md)  
> - [`docs/C_SWEEP_ARCHITECTURE.md`](file:///c:/Users/ern0e/EAGLEULTRASONiK/docs/C_SWEEP_ARCHITECTURE.md)  
> - [`docs/C_SWEEP_SCENARIOS.md`](file:///c:/Users/ern0e/EAGLEULTRASONiK/docs/C_SWEEP_SCENARIOS.md)  
> - [`docs/C_SWEEP_IMPLEMENTATION_COMPLIANCE_AUDIT.md`](file:///c:/Users/ern0e/EAGLEULTRASONiK/docs/C_SWEEP_IMPLEMENTATION_COMPLIANCE_AUDIT.md)  
> - [`docs/C_SWEEP_IMPLEMENTATION_GAP_BACKLOG.md`](file:///c:/Users/ern0e/EAGLEULTRASONiK/docs/C_SWEEP_IMPLEMENTATION_GAP_BACKLOG.md)  
> - [`docs/C_SWEEP_GAP008_PHYSICAL_CALIBRATION_REPORT.md`](file:///c:/Users/ern0e/EAGLEULTRASONiK/docs/C_SWEEP_GAP008_PHYSICAL_CALIBRATION_REPORT.md)  
> - [`docs/C_SWEEP_PROTOTYPE_SCOPE_CLOSURE.md`](file:///c:/Users/ern0e/EAGLEULTRASONiK/docs/C_SWEEP_PROTOTYPE_SCOPE_CLOSURE.md)  
> **Report Date:** August 17, 2026  

---

## 1. Scope

This document establishes the final verification status for the Frequency Sweep / Shifting subsystem of the EAGLEULTRASONİK controller across Phase C-Faz 1–3 prototype development.

The verification scope encompasses:
* **Firmware Implementation:** STM32G474RE HAL firmware (`x9c103s.c`, `x9c103s.h`, `esp32_uart.c`, `system_state.h`).
* **HMI / Master Controller Integration:** ESP32-S3 FreeRTOS controller & Nextion display bridge (`ekran_kontrol.ino`).
* **Protocol & Telemetry:** Multi-drop RS485 ASCII UART framing and 10-field status telegram format (`STAT`).
* **Automated Testing:** Pytest Hardware-in-the-Loop test suite (`test_hil_uart.py`).
* **Physical Calibration:** X9C103S wiper voltage ($V_W$) and PA0 ADC IN1 feedback readback calibration.

---

## 2. Requirements Verification

* **Total Requirements Audited:** 71 (`SWP-REQ-001` .. `SWP-REQ-071` in `docs/C_SWEEP_REQUIREMENTS.md`)
* **Verified Requirements:** 71 / 71 (100% compliant at prototype scope).
* **Summary:**
  * Dual center frequency selection (28 kHz / 40 kHz) verified.
  * Triangle cyclic sweep algorithm (400 ms cycle, 50 ms step) verified.
  * Selection arming (`sweep_enabled`) vs active stepping (`sweep_active`) decoupling verified.
  * Parametric `STEP_INCREMENT` (`1..8`, default `4`) and independent `SWEEP_SPAN` (`1..4` kHz, default `2` = $\pm 2\text{ kHz}$) verified.
  * Safety interlocks (`SET_FREQ` sweep termination, DEGAS sweep exclusion, RUNNING commissioning lockout, SafeStop disarm) verified.

---

## 3. Architecture Verification

* **Total ADRs Verified:** 7 (`ADR-01` .. `ADR-07` in `docs/C_SWEEP_ARCHITECTURE.md`)
* **Status:** 7 / 7 **VERIFIED & COMPLIANT**.
  * `ADR-01` (Decoupled Selection vs Execution): Implemented in `x9c103s.c` and `esp32_uart.c`.
  * `ADR-02` (`SET_FREQ` Active Sweep Termination): Implemented in `esp32_uart.c` line 446.
  * `ADR-03` (SafeStop Priority): Implemented in `system_state.c` line 95.
  * `ADR-04` (DEGAS Mode Sweep Exclusion): Implemented in `system_state.h` and `esp32_uart.c`.
  * `ADR-05` (Service-Only Configuration & NVS Persistence): Implemented in `ekran_kontrol.ino`.
  * `ADR-06` (10-Field Telemetry Framing): Implemented in `esp32_uart.c` and `ekran_kontrol.ino`.
  * `ADR-07` (Parametric Step & Span Model): Implemented in `x9c103s.c` and `x9c103s.h`.

---

## 4. Scenario Verification

* **Total Scenarios Audited:** 54 (`SWP-SCN-001` .. `SWP-SCN-054` in `docs/C_SWEEP_SCENARIOS.md`)
* **Status:** 54 / 54 **VERIFIED / PASSED** (45 verified via automated HIL test suite, 9 verified via physical PA0 DMM calibration).

---

## 5. Implementation Compliance Result

* **Audit Baseline:** `docs/C_SWEEP_IMPLEMENTATION_COMPLIANCE_AUDIT.md`
* **Compliance Matrix:**
  * **Initial Audit Result:** 38 PASS, 6 FAIL, 10 PARTIAL, 17 UNVERIFIED.
  * **Remediation Result:** All 6 FAILs and 10 PARTIALs resolved across `SWP-GAP-001` .. `SWP-GAP-006`. All 17 UNVERIFIED items resolved across `SWP-GAP-007` .. `SWP-GAP-009`.
  * **Final Compliance Rating:** **100% COMPLIANT** for Prototype Scope.

---

## 6. GAP-001..009 Verification Summary

| Gap ID | Description | Resolution / Implementation | Verification Method | Status |
| :--- | :--- | :--- | :--- | :---: |
| **`SWP-GAP-001`** | `SET_FREQ` Active Sweep Reset | Added `X9C103S_SetSweepEnabled(0U)` call inside `SET_FREQ` handler | HIL Test `test_swp_03` | **PASS** |
| **`SWP-GAP-002`** | Parametric `STEP_INCREMENT` Model | Added `s_step_increment` (`1..8`, default `4`) & `SET_STEP_INC` command | HIL Test `test_swp_04` | **PASS** |
| **`SWP-GAP-003`** | `STAT` Field 10 `swp_st` Expansion | Appended 10th CSV field `swp_st = (enabled << 1) \| active` to `STAT` | HIL Test `test_swp_01` | **PASS** |
| **`SWP-GAP-004`** | `SYS_MODE_DEGAS` & Interlock | Added `SYS_MODE_DEGAS` enum & `ERR:SWEEP_PROHIBITED_IN_DEGAS` error | HIL Test `test_swp_05` | **PASS** |
| **`SWP-GAP-005`** | Decoupled IDLE Sweep Arming | Conditioned wiper stepping on `SYS_MODE_RUNNING`; arming allowed in IDLE | HIL Test `test_swp_01` | **PASS** |
| **`SWP-GAP-006`** | Dynamic Span & Period Commands | Added independent `SET_SWP_SPAN:<1..4>` & `SET_SWP_PER:<100..1000>` | HIL Test `test_swp_06..08` | **PASS** |
| **`SWP-GAP-007`** | Automated HIL Suite Expansion | Added 9 explicit Frequency Sweep regression tests (`test_swp_01..09`) | HIL Suite Execution | **PASS** |
| **`SWP-GAP-008`** | Physical PA0/VW Calibration | 10-point DMM & PA0 ADC feedback calibration ($1.05\text{ V} \dots 3.23\text{ V}$) | DMM & PA0 ADC Log | **PASS** |
| **`SWP-GAP-009`** | Prototype Sweep Endurance Sample | Multi-cycle active sweep execution stability (`test_swp_10`) | HIL Test `test_swp_10` | **PASS** |

---

## 7. GAP-010 Deferred Status

* **Gap ID:** `SWP-GAP-010` (Fine-Sweep 1-Step Physical Transducer Validation)
* **Status:** **`DEFERRED — FINAL MOTOR/POWER-CARD HARDWARE REQUIRED`**
* **Technical Detail:** Software support for fine sweep (`STEP_INCREMENT = 1`) is fully implemented, selectable, and verified in firmware/HMI. However, physical acoustic cleaning efficacy and transducer resonance tuning under 1-step increment requires final high-power power-card and transducer tank hardware. The current prototype default remains `STEP_INCREMENT = 4`.

---

## 8. Automated HIL Verification

* **Test Suite File:** [`test_hil_uart.py`](file:///c:/Users/ern0e/EAGLEULTRASONiK/test_hil_uart.py)
* **Execution Environment:** Raspberry Pi 4 Test Host (`/dev/ttyACM0` ESP32, `/dev/ttyACM1` STM32 ST-Link VCP)
* **Total Automated Tests:** 30
* **Pass Rate:** **30 / 30 PASSED (100%)**
* **Exit Code:** `0`
* **Test Inventory:**
  * `test_01_id_assignment` .. `test_17_physical_loopback_readback` (Base HIL: PASSED)
  * `test_f1_set_freq_28` .. `test_f3_set_freq_invalid` (Dual Freq: PASSED)
  * `test_swp_01_idle_sweep_off_and_on` .. `test_swp_10_endurance_stability_sample` (Sweep Regression: PASSED)

---

## 9. X9C / VW / PA0 Physical Prototype Verification

* **Calibration Report File:** [`docs/C_SWEEP_GAP008_PHYSICAL_CALIBRATION_REPORT.md`](file:///c:/Users/ern0e/EAGLEULTRASONiK/docs/C_SWEEP_GAP008_PHYSICAL_CALIBRATION_REPORT.md)
* **Total Calibration Points Measured:** 10 / 10
* **Acceptance Limits:** Wiper Voltage $V_W \pm 2\%$, ADC Feedback Error $< 10\text{ mV}$.
* **Measured Summary:**
  * 28 kHz Sweep Baseline (Steps 32, 36, 40, 44, 48): $1.053\text{ V} \dots 1.584\text{ V}$ (**PASS**)
  * 40 kHz Sweep Baseline (Steps 82, 86, 90, 94, 98): $2.704\text{ V} \dots 3.234\text{ V}$ (**PASS**)
  * Max wiper voltage $3.234\text{ V} < 3.30\text{ V}$ rail voltage safety limit.

---

## 10. Service Configuration Verification

* **Access Control:** Gated behind Service Menu authentication (`dogru_sifre = "123456"`) in ESP32 HMI.
* **Commands Verified:**
  * `SET_STEP_INC:<1..8>` $\rightarrow$ Responds `ACK:STEP_INC:<val>` (IDLE), `ERR:LOCKED_SYS_RUNNING` (RUNNING), `ERR:INVALID_PARAM` (Out of range).
  * `SET_SWP_SPAN:<1..4>` $\rightarrow$ Responds `ACK:SWP_SPAN:<val>` (IDLE), `ERR:LOCKED_SYS_RUNNING` (RUNNING), `ERR:INVALID_PARAM` (Out of range).
  * `SET_SWP_PER:<100..1000>` $\rightarrow$ Responds `ACK:SWP_PER:<val>` (IDLE), `ERR:LOCKED_SYS_RUNNING` (RUNNING), `ERR:INVALID_PARAM` (Out of range).
* **Parameter Independence:** Confirmed that modifying `SWEEP_SPAN` does not mutate `STEP_INCREMENT`, and modifying `STEP_INCREMENT` does not mutate `SWEEP_SPAN`.

---

## 11. Recipe Integration Verification

* **Functionality:** Operator recipe selection on Nextion HMI (Programs P1, P2, P3) transmits setpoints (`SET_TIME`, `SET_TEMP`, `SET_POWER`, `SET_FREQ`, `SWEEP:ON/OFF`) to STM32.
* **Verification:** Recipe loading, temporary edit, and START sequence verified in `test_hil_uart.py` and hardware bench tests.

---

## 12. DEGAS / Sweep Interlock Verification

* **Functionality:** `SYS_MODE_DEGAS` operating mode explicitly prohibits sweep execution.
* **Verification:**
  * Transition to `SYS_MODE_DEGAS` immediately disables active sweep (`swp_st = 0`).
  * `SWEEP:ON` issued while in DEGAS mode responds with `ERR:SWEEP_PROHIBITED_IN_DEGAS` and leaves sweep disabled.
  * Verified in HIL Test `test_swp_05`.

---

## 13. START / STOP / SafeStop Verification

* **START Behavior:** If `sweep_enabled == 1` in IDLE mode (`swp_st = 2`), issuing `START` transitions mode to `SYS_MODE_RUNNING` and activates 400 ms triangle wiper stepping (`swp_st = 3`).
* **STOP / SafeStop Behavior:** Issuing `STOP` or triggering a watchdog/over-temp fault immediately disables wiper stepping, clears `sweep_active`, and returns machine to safe IDLE mode.
* **Verification:** Verified in HIL Tests `test_swp_02`, `test_swp_09`, and `test_16`.

---

## 14. Telemetry Verification

* **Format:** `STAT,<TankID>,<Mode>,<rem_sec>,<temp_x10>,<relay>,<power>,<freq>,<fault>,<prov>,<swp_st>`
* **Field 10 (`swp_st`) Bitmask:**
  * `0` (`00`): Sweep disabled / inactive.
  * `2` (`10`): Sweep selected / armed in IDLE mode.
  * `3` (`11`): Sweep selected / actively stepping in RUNNING mode.
* **Verification:** Verified across all 30 automated HIL tests.

---

## 15. Persistence Verification

* **Storage Engine:** ESP32 Non-Volatile Storage (NVS Preferences under namespace `"ultra"`).
* **Persisted Keys:** `step_inc` (default `4`), `swp_span` (default `2`), `swp_per` (default `400`).
* **Verification:** Read on boot (`nvsYukle()`) and write on change (`nvsKaydet()`) verified via serial debug logging.

---

## 16. Known Limitations

* **Wiper Voltage Readback vs Acoustic Output:** PA0 ADC IN1 measures potentiometer wiper voltage $V_W$. It does not measure physical ultrasonic acoustic wave frequency inside liquid medium.
* **Desktop Prototype Bench Constraints:** Testing was conducted on a desktop prototype rig using ST-Link VCP and USB-serial bridge. High-power AC switching was evaluated via TRIAC pulse delay logging rather than full acoustic bath load.

---

## 17. Deferred Final-Hardware Validation

The following items cannot be completed on the prototype bench setup and are explicitly categorized as:

### `DEFERRED — FINAL MOTOR/POWER-CARD HARDWARE REQUIRED`

* **Direct Ultrasonic Output Frequency Measurement** (`DIRECT ULTRASONIC FREQUENCY VALIDATION — DEFERRED`)
* **Final Ultrasonic Motor / Transducer Load Optimization**
* **Final High-Voltage Power-Card Production Validation**
* **66-Minute High-Power Thermal Soak with Final Transducer Hardware**
* **Physical Validation of Fine-Sweep Optimization (`STEP_INCREMENT = 1`)** (`SWP-GAP-010`)
* **Production Hardware Certification, Field Trials, and EMI/EMC Validation** (`FIELD / FINAL HARDWARE VALIDATION — NOT COMPLETE`)

---

## 18. Final Prototype Acceptance Decision

### Primary Prototype Acceptance Statement:

$$ \text{\bfseries C PROTOTYPE SWEEP — CLOSED} $$

---

### Subsidiary Hardware Boundary Declarations:

$$ \text{\bfseries FIELD / FINAL HARDWARE VALIDATION — NOT COMPLETE} $$

$$ \text{\bfseries DIRECT ULTRASONIC FREQUENCY VALIDATION — DEFERRED} $$
