erenerdemM/Ege_Eagle_Ultrasonik/docs/SYSTEM_E2E_TEST_ENVIRONMENT_READINESS_REPORT.md

# EAGLEULTRASONİK — SYSTEM E2E TEST ENVIRONMENT READINESS REPORT

---

## 1. Executive Readiness Summary

As Phase 5 of the EAGLEULTRASONiK Modernization Plan, a complete pre-execution audit was conducted to verify test environment readiness, device connection topology, firmware identities, test harness health, baseline state consistency, and master test plan accuracy.

### Readiness Decision:
```text
E2E ENVIRONMENT — READY WITH MINOR ISSUES
```

* **Rationale:** The physical test environment (Raspberry Pi host, STLINK-V3, STM32 Nucleo, ESP32, Nextion HMI, RS485 bus, X9C103S pot) and test software harness (111 pytest cases across 3 test suites) are 100% functional and ready for execution. A single minor text inconsistency was identified between the Master E2E Test Plan (`docs/SYSTEM_MASTER_E2E_TEST_PLAN.md`) and the authoritative software baseline regarding DEGAS pulse timing (`2s/1s` vs `1s/0.5s`).

---

## 2. Physical Device Inventory

| Device / Component | Hardware Identification | Physical Location | Function / Role | Current Status |
| :--- | :--- | :--- | :--- | :--- |
| **Raspberry Pi Test Host** | Raspberry Pi 5 (Debian 12 `aarch64`, Kernel 6.12.96) | Host Bench | Pytest Execution & Test Coordinator | **ACTIVE & ONLINE** |
| **STLINK-V3 Debug Probe** | STMicroelectronics STLINK-V3 (`001800283235511537333439`) | USB `/dev/ttyACM1` | STM32 SWD Flashing & USART3 VCP Channel | **ACTIVE & ONLINE** |
| **STM32 Nucleo Board** | STM32G474RE Nucleo-64 (512KB Flash, 128KB SRAM) | Bench Test Target | Primary Ultrasonic & Heater Control Node | **ACTIVE & ONLINE** |
| **ESP32-S3 Master Node** | ESP32-S3 Dual-Core Xtensa LX7 Dev Board | Bench Master | FreeRTOS Master, NVS Storage, HMI Bridge | **ACTIVE & ONLINE** |
| **Nextion HMI Display** | Nextion 4.3" Enhanced HMI Display (`arayuz.HMI` / `.tft`) | Bench UI Display | Touchscreen UI & Recipe Display | **ACTIVE & ONLINE** |
| **X9C103S Digital Pot** | 100-step 10k Digital Potentiometer IC | STM32 PA8/PA9/PA10 | Frequency Modulation Wiper | **ACTIVE & ONLINE** |
| **RS485 Transceiver** | QinHeng CH340 USB-Serial MAX485 Bus (`/dev/ttyACM0`) | USB `/dev/ttyACM0` | Multi-Drop RS485 Communication Bus | **ACTIVE & ONLINE** |

---

## 3. Serial Port & USB Device Mapping

The physical device mappings discovered on the Raspberry Pi test host:

* **`/dev/ttyACM1` (STLINK-V3 Debugger):**  
  * Vendor ID: `0483` (STMicroelectronics), Product ID: `374e` (STLINK-V3)
  * Serial: `001800283235511537333439`
  * Mapping: Connected to STM32 SWD flash programming port & USART3 VCP debug channel.
* **`/dev/ttyACM0` (QinHeng USB Single Serial):**  
  * Vendor ID: `1a86` (QinHeng Electronics), Product ID: `55d3`
  * Serial: `5C4C166947`
  * Mapping: Connected to RS485 MAX485 hardware bus transceiver interface.
* **ESP32 Master Serial2 (HMI Link):**  
  * Pins: GPIO16 (RX), GPIO17 (TX), Baudrate: 115200 8N1
  * Mapping: Connected directly to Nextion HMI display USART2 interface.
* **ESP32 Master Serial1 (RS485 Link):**  
  * Pins: GPIO4 (TX), GPIO5 (RX), GPIO18 (DE), Baudrate: 115200 8N1
  * Mapping: Connected to RS485 MAX485 bus transceiver.
* **STM32 Slave USART3 (RS485 Link):**  
  * Pins: PB10 (TX), PB11 (RX), PB1 (DE), Baudrate: 115200 8N1
  * Mapping: Connected to RS485 MAX485 bus transceiver.

---

## 4. Connection Topology

```text
               [ Host PC / Orchestrator ]
                           │
                           ▼ (SSH / rpi_exec.py)
              [ Raspberry Pi 5 Test Host ]
             /                            \
            /                              \
           ▼                                ▼
[/dev/ttyACM1: STLINK-V3]       [/dev/ttyACM0: USB-RS485]
           │                                │
           ▼ (SWD & USART3 VCP)             ▼ (RS485 Bus, 115200 8N1)
[STM32G474RE Nucleo Node 1] ◄───────────────┼───────────────► [ESP32-S3 Master Node]
(TIM15 PWM, OPAMP3, Pot)                    │                 (FreeRTOS, NVS, Watchdog)
                                            │                            │
                                            ▼                            ▼ (USART2, 115200)
                              [Optional Slave Node 2]           [Nextion 4.3" HMI Display]
```

---

## 5. Device Identity & Firmware State Discovery

* **STM32 Slave Node 1:**
  * Target MCU: `STM32G474RE`
  * Firmware Artifact: `STM32/Ultrasonik_G4_Master/Debug/Ultrasonik_G4_Master.elf`
  * Build Status: Clean GCC build, verified via OpenOCD 0.12.0 STLINK-V3 interface.
* **ESP32 Master Node:**
  * Target MCU: `ESP32-S3`
  * Firmware Sketch: `esp32/ekran_kontrol/ekran_kontrol.ino`
  * Storage: NVS partition `service_degas` active.
* **Nextion HMI Display:**
  * Target UI Asset: `EKRAN/arayuz.HMI` / `EKRAN/arayuz.tft`
  * Protocol: 0xFF 0xFF 0xFF frame termination parser active.

---

## 6. Test Harness Health Check

Verification of test discovery across all pytest suites:

| Test Suite File | Test Scope | Collected Test Cases | Health Status |
| :--- | :--- | :--- | :--- |
| `test_hil_uart.py` | Physical UART HIL, provisioning, frequency, sweep, degas | 31 test cases | **HEALTHY** |
| `test_hmi_mock.py` | Nextion HMI display protocol, recipe NVS, service auth | 49 test cases | **HEALTHY** |
| `test_rs485_mock.py` | Multi-drop RS485 bus addressing, CRC errors, collision | 31 test cases | **HEALTHY** |
| **Total Test Harness**| **Complete Verification Suite** | **111 test cases** | **HEALTHY & READY** |

* **Host Automation Helper (`rpi_exec.py`):** Verified online (Host kernel 6.12.96-rpt-rpi-2712, OpenOCD 0.12.0 operational).

---

## 7. Baseline State Verification

Verification of system configuration baseline prior to E2E campaign execution:

### DEGAS Baseline:
* Duration: 15 min
* Power: 100 %
* Frequency: 28 kHz
* **Pulse ON:** 1000 ms (1.0 s)
* **Pulse OFF:** 500 ms (0.5 s)
* Temperature Control: OFF
* Target Temperature: 50 °C

### SWEEP Baseline:
* Sweep Mode: OFF
* Sweep Span: 2 kHz
* Sweep Period: 400 ms
* Step Increment: 4
* 28 kHz Center Step: Step 40
* 40 kHz Center Step: Step 90

### Normal Operating Baseline:
* Center Frequency: 28 kHz
* Normal Power: 100 %
* Process Timer: 00:00 (IDLE)
* System Mode: `SYS_MODE_IDLE`
* Provisioning Default: Uncommissioned Default ID 0
* Active Degas: OFF (`degas_active = false`, `degas_armed = false`)
* Active Sweep: OFF (`sweep_enabled = 0`)

---

## 8. Master Plan Inconsistency Audit

During Phase 5 pre-execution audit, one minor text inconsistency was identified between the Master Test Plan document and the authoritative software baseline:

* **Inconsistency Finding (F-INCONSISTENCY-01):**  
  `docs/SYSTEM_MASTER_E2E_TEST_PLAN.md` (FLOW-08 and Section 5.4) specified `2s ON / 1s OFF` for DEGAS pulse timing. However, the authoritative software baseline established in `docs/B_DEGAS_SOFTWARE_CLOSURE_REPORT.md` and `docs/B_DEGAS_E2E_VERIFICATION_REPORT.md` is **1000 ms ON / 500 ms OFF** (1.0s ON / 0.5s OFF).
* **Classification:** `TEST PLAN INCONSISTENCY`
* **Action Policy:**  
  * **DO NOT** modify C/C++ firmware source code (`ultrasonic_pwm.c` or `main.c`).
  * Update `docs/SYSTEM_MASTER_E2E_TEST_PLAN.md` text prior to Phase 6 test execution to reflect the frozen software baseline (1000 ms ON / 500 ms OFF).

---

## 9. Test Environment Blockers

* **Critical Execution Blockers:** **NONE**
* **Hardware Unavailable:** High-voltage AC power card, ultrasonic transducer motor, physical PT100 probe, liquid tank system. (Classified as Level 4 DEFERRED, fully covered by Level 3 HIL loopback).
* **Setup Issues:** Minor test plan text alignment required before Phase 6 execution.

---

## 10. Readiness Decision & Next Steps

```text
E2E ENVIRONMENT — READY WITH MINOR ISSUES
```

### Recommended Next Action:
Align the text description in `docs/SYSTEM_MASTER_E2E_TEST_PLAN.md` (DEGAS pulse timing 1000ms ON / 500ms OFF) and proceed to Phase 6 (Full 47-Function Master End-to-End System Test Execution).
