erenerdemM/Ege_Eagle_Ultrasonik/docs/SYSTEM_P0_REVALIDATION_REPORT.md

# EAGLEULTRASONİK — INDEPENDENT P0 RISK RE-VALIDATION REPORT

---

## 1. Executive Summary

This report delivers the authoritative independent re-validation for the **3 Priority 0 (P0)** safety-critical risks identified in the EAGLEULTRASONiK system architecture: **RSK-001**, **RSK-002**, and **RSK-003**.

Re-validation was conducted via 4 independent specialist subagents (`stm32-specialist`, `esp32-hmi-specialist`, `code-reviewer`, `system-architect`). All 4 specialist workstreams produced **100% unanimous agreement**. All three P0 findings were independently re-confirmed as genuine, safety-critical defects.

### Final Phase 12 P0 Classification:
```text
P0 REVALIDATION — ALL THREE CONFIRMED
```

---

## 2. Independent Specialist Consensus Summary

| Specialist Workstream | RSK-001 (Fault Wipe on STOP) | RSK-002 (UART Transmit Spinlock) | RSK-003 (Touch Lockout Bypass) | Workstream Verdict |
| :--- | :--- | :--- | :--- | :--- |
| **`stm32-specialist`** | **CONFIRMED DEFECT** | **CONFIRMED DEFECT** | **CONFIRMED DEFECT** | 100% Unanimous |
| **`esp32-hmi-specialist`**| **CONFIRMED DEFECT** | **CONFIRMED DEFECT** | **CONFIRMED DEFECT** | 100% Unanimous |
| **`code-reviewer`** | **CONFIRMED DEFECT** | **CONFIRMED DEFECT** | **CONFIRMED DEFECT** | 100% Unanimous |
| **`system-architect`** | **CONFIRMED DEFECT** | **CONFIRMED DEFECT** | **CONFIRMED DEFECT** | 100% Unanimous |

* **Specialist Disagreements:** **NONE.** Zero conflicting opinions or evidence discrepancies were recorded among specialists.

---

## 3. Deep Forensic Re-Validation of P0 Risks

### 3.1 RSK-001: Hardware Fault Bitmask Reset on `STOP` Command
* **Source Location:** [`esp32_uart.c:335`](file:///c:/Users/ern0e/EAGLEULTRASONiK/STM32/Ultrasonik_G4_Master/Core/Src/esp32_uart.c#L335) & [`system_state.c:106`](file:///c:/Users/ern0e/EAGLEULTRASONiK/STM32/Ultrasonik_G4_Master/Core/Src/system_state.c#L106)
* **Call Chain:** RS485 `T<id>:STOP` Frame Arrival $\to$ `ProcessLine()` $\to$ `SystemState_SafeStop(STOP_REASON_USER_STOP)` $\to$ `g_system_state.mode = SYS_MODE_IDLE; g_system_state.fault_flags = FAULT_NONE;`.
* **Triggering Condition:** Sending a `STOP` command while an active physical fault (e.g., PT100 sensor open/short circuit, zero-cross signal loss) is active.
* **Observable Consequence:** `g_system_state.fault_flags` is cleared to `0x00`. If a `START` command (`T<id>:START`) arrives in the same superloop cycle before `PT100_ADC_Process()` or `UltrasonicPWM_Process()` re-evaluates sensor pins, `START` passes `if (g_system_state.mode != SYS_MODE_FAULT)` and transitions to `SYS_MODE_RUNNING` with an un-cleared physical fault!
* **Requirement / ADR Conflict:** Direct violation of [`Manifesto_V3.md:§4.1`](file:///c:/Users/ern0e/EAGLEULTRASONiK/Manifesto_V3.md#L147-L156), [`§4.2`](file:///c:/Users/ern0e/EAGLEULTRASONiK/Manifesto_V3.md#L157-L167), and [`§5.1`](file:///c:/Users/ern0e/EAGLEULTRASONiK/Manifesto_V3.md#L193-L206) (Safety Fault Retention Invariants).
* **Test Detection Status:** 🔴 **False Pass** in [`test_hil_uart.py:test_04_stop_clears_fault`](file:///c:/Users/ern0e/EAGLEULTRASONiK/test_hil_uart.py#L408). The test asserts that `STOP` resets `fault_flags` without checking if the hardware fault signal is still present.
* **Confidence Level:** **HIGH**

---

### 3.2 RSK-002: Spinlock Deadlock in `RS485_Transmit_Blocking()`
* **Source Location:** [`esp32_uart.c:69-83`](file:///c:/Users/ern0e/EAGLEULTRASONiK/STM32/Ultrasonik_G4_Master/Core/Src/esp32_uart.c#L69-L83)
* **Call Chain:** Emergency Disarm / SafeStop Call $\to$ `RS485_Transmit_Blocking()` $\to$ `while (tx_busy) {}`.
* **Triggering Condition:** `RS485_Transmit_Blocking()` being called while `tx_busy == 1` from an interrupt handler or critical section where `USART3` interrupts are masked.
* **Observable Consequence:** Because `tx_busy` is cleared exclusively by `HAL_UART_TxCpltCallback()` in the `USART3` ISR, disabling interrupts prevents `tx_busy` from ever resetting to `0`. The MCU enters an infinite loop inside `while (tx_busy)`, completely locking the CPU and halting superloop process timer execution until the 1000ms IWDG hardware watchdog resets the processor.
* **Requirement / ADR Conflict:** Direct violation of [`Manifesto_V3.md:§1.1`](file:///c:/Users/ern0e/EAGLEULTRASONiK/Manifesto_V3.md#L16-L25) and [`§6`](file:///c:/Users/ern0e/EAGLEULTRASONiK/Manifesto_V3.md#L228-L236) (Superloop Non-Blocking & Execution Timeliness Invariants).
* **Test Detection Status:** ⚪ **Not Detected** in current Python test suites.
* **Confidence Level:** **HIGH**

---

### 3.3 RSK-003: Critical Touch Lockout Omissions During Normal Washing Cycles
* **Source Location:** [`ekran_kontrol.ino:L1046-L1109`](file:///c:/Users/ern0e/EAGLEULTRASONiK/esp32/ekran_kontrol/ekran_kontrol.ino#L1046-L1109) & [`L886-L932`](file:///c:/Users/ern0e/EAGLEULTRASONiK/esp32/ekran_kontrol/ekran_kontrol.ino#L886-L932)
* **Call Chain:** Nextion HMI Touch Event (`TIME_UP`, `TEMP_UP`, `GUC_UP`, `CMD_FREQ`, `P1_SEL`) $\to$ `komutIsle()` $\to$ Updates local setpoints $\to$ Transmits serial command (`stmSetTime`, `stmSetTemp`, `stmSetFreq`).
* **Triggering Condition:** Operator touching setpoint adjustment buttons on the Nextion display during an active normal washing cycle (`makine_calisiyor[secili_goz] == true`).
* **Observable Consequence:** Handlers check `if (degas_active[secili_goz]) return;`, but **completely omit `makine_calisiyor[secili_goz]`**. Target time, target temperature, power level, or ultrasonic frequency (28kHz vs 40kHz) can be mutated mid-wash while transducers are energized. Tapping `P1_SEL` during an active wash resets local ESP32 countdown state while the STM32 slave remains in `SYS_MODE_RUNNING`, causing master-slave state desynchronization.
* **Requirement / ADR Conflict:** Direct violation of [`Manifesto_V3.md:§3.2`](file:///c:/Users/ern0e/EAGLEULTRASONiK/Manifesto_V3.md#L113-L119) and [`§3.4`](file:///c:/Users/ern0e/EAGLEULTRASONiK/Manifesto_V3.md#L131-L136) (Active State Parameter Immutability Invariants).
* **Test Detection Status:** 🔴 **False Pass** in [`test_hmi_mock.py:test_degas_04`](file:///c:/Users/ern0e/EAGLEULTRASONiK/test_hmi_mock.py#L1093). The mock suite asserts that setpoints are blocked during DEGAS, but fails to assert lockout during normal wash cycles.
* **Confidence Level:** **HIGH**

---

## 4. Manifesto Impact & Required Qualifications

The master technical manifesto [`docs/EAGLEULTRASONIK_SYSTEM_MANIFESTO.md`](file:///c:/Users/ern0e/EAGLEULTRASONiK/docs/EAGLEULTRASONIK_SYSTEM_MANIFESTO.md) remains fully authoritative for high-level system architecture, layer mapping, and baseline parameters.

However, the following explicit qualifications must be applied prior to production code deployment:

1. **Manifesto §15 (Safety & Defensive Architecture):** Statement claiming `STOP` clears fault state must be qualified: `STOP` clears `fault_flags` **ONLY IF** hardware signal re-check confirms physical fault is absent.
2. **Manifesto §9 (Communication & Driver Architecture):** Statement claiming blocking UART driver execution must be qualified: `RS485_Transmit_Blocking()` must implement a non-blocking timeout counter or non-blocking transmit queueing to prevent ISR spinlocks.
3. **Manifesto §7 (Nextion HMI Touch Lockout):** Statement claiming setpoint edits are locked during active operation must be qualified: ESP32 HMI setpoint touch handlers must be updated to check `if (makine_calisiyor[secili_goz] || degas_active[secili_goz]) return;`.

---

## 5. Required Future Test Suite Additions

1. **RSK-001 Test Addition:** Inject continuous hardware fault (PT100 open), send `STOP`, then immediately send `START` before ADC polling to assert `ERR:FAULT_ACTIVE` rejection.
2. **RSK-002 Test Addition:** Bench C spinlock test executing `RS485_Transmit_Blocking()` under masked interrupt conditions to verify non-blocking timeout counter.
3. **RSK-003 Test Addition:** Add unit test in `test_hmi_mock.py` asserting that `TIME_UP`, `TEMP_UP`, `GUC_UP`, `CMD_FREQ`, and `P1_SEL` return without state mutation when `makine_calisiyor[secili_goz] == True`.

---
*No source files or test scripts were modified during this re-validation.*
