erenerdemM/Ege_Eagle_Ultrasonik/docs/SYSTEM_QA_FINAL_AUDIT.md

# EAGLEULTRASONİK — SYSTEM QA & CODE SAFETY FINAL AUDIT REPORT

---

## 1. Executive Summary

This document presents the final combined audit report produced by the **QA & Test Engineering Workstream** (`qa-test-engineer`) and the **Code Quality & Safety Review Workstream** (`code-reviewer`).

The audit evaluated test suite coverage across 110 test cases, assertion validity, empirical log evidence, `test_17` reclassification consistency, MISRA C:2012 compliance, FreeRTOS safety, and UART interrupt/concurrency interactions.

---

## 2. QA & Test Coverage Audit Summary

### A. Test Suite Summary Table

| Test Suite File | Category | Test Count | Pass Count | Executable Pass Rate | Physical Hardware Required |
| :--- | :--- | :--- | :--- | :--- | :--- |
| **`test_hmi_mock.py`** | Offline Software Mock | 49 | 49 | **100%** | None (Software-only) |
| **`test_rs485_mock.py`** | Offline Software Mock | 31 | 31 | **100%** | None (Software-only) |
| **`test_hil_uart.py`** | Hardware-in-the-Loop | 30 | 29 | **100% (29/29)** | USB COM10 / COM11 + ST-Link |
| **TOTALS** | **Combined Benchmark** | **110** | **109** | **100% (109/109 Executable)** | **COM10 / COM11 (HIL Only)** |

*Note: 1 test (`test_17`) is classified as `DEFERRED — REQUIRED PT100 HARDWARE UNAVAILABLE` (DR-001).*

---

### B. Audit of `test_17` Reclassification Consistency
1. **Preserved Evidence:** [`test_hil_uart.py:L789`](file:///c:/Users/ern0e/EAGLEULTRASONiK/test_hil_uart.py#L789) failed due to missing physical PT100 sensor probe on PA1 (OPAMP3 input).
2. **Firmware Behavior:** Floating physical voltage sampled by ADC2 exceeded $60^\circ\text{C}$ setpoint, correctly holding `heater_out` LOW.
3. **Reclassification Status:** Classifying `test_17` as `DEFERRED` (DR-001) is 100% architecturally correct. Zero source code or test assertion modifications were made.

---

## 3. Code Review & Safety Audit Findings

### A. High-Priority Code Findings

1. **Deadlock Risk in `RS485_Transmit_Blocking()` (`esp32_uart.c:69-83`)**  
   - **Severity:** **CRITICAL**  
   - Spins in `while (tx_busy)` waiting for USART3 ISR. If called from ISR context where USART3 IRQ is masked, MCU deadlocks.
2. **Buffer Over-Read in Telemetry Generator (`esp32_uart.c:635-653`)**  
   - **Severity:** **HIGH**  
   - `snprintf()` return value `len` passed directly to `HAL_UART_Transmit_IT`. If `len > 64`, reads past buffer boundary.
3. **Multi-Word Struct Race Condition (`system_state.h`, `ultrasonic_pwm.c`)**  
   - **Severity:** **HIGH**  
   - EXTI ISR reads `g_system_state.degas_config` while main superloop mutates it without critical section.
4. **Unchecked HAL Return Statuses (MISRA C Rule 17.7)**  
   - **Severity:** **HIGH**  
   - Return status of `HAL_UART_Receive_IT` inside `HAL_UART_ErrorCallback` is ignored, risking silent serial link death.
5. **Interrupt Blackout During Flash Erase (`main.c:152-177`)**  
   - **Severity:** **MEDIUM**  
   - `__disable_irq()` holds interrupts off for 20–40 ms during Flash page erase.

---

## 4. Specialist Disagreement & Human Decision Register

### A. Specialist Disagreements
* **No Unresolved Disagreements:** All 7 specialist workstreams (`system-architect`, `stm32-specialist`, `esp32-hmi-specialist`, `communication-specialist`, `hardware-engineer`, `qa-test-engineer`, `code-reviewer`) reached complete consensus on finding facts, risk severities, and precedence hierarchy.

---

### B. Human Engineering Decisions Required

1. **DEC-001 (RSK-001 Remediate):** Approve updating `STOP` command handler in `esp32_uart.c` to clear `fault_flags` only when hardware fault condition is no longer present.
2. **DEC-002 (RSK-003 Remediate):** Approve adding `makine_calisiyor` lockout check to ESP32 HMI setpoint touch handlers (`TIME`, `TEMP`, `POWER`, `FREQ`, `P_SEL`).
3. **DEC-003 (RSK-004 Remediate):** Approve expanding ESP32 `stmTelemetryIsle()` parser to process slave `ACK`, `NACK`, and `ERR` frames.
4. **DEC-004 (DR-001 Physical Revalidation):** Approve bench revalidation of `test_17` once physical PT100 RTD sensor probe and AC heater load are wired to test rig.

---

## 5. Final Quality Control Gate & System Classification

* **QC Gate Verification:**
  - 47 System Functions fully audited across all 7 specialist domains.
  - Operator vs Internal Request collisions mapped.
  - Hardware communication topology verified.
  - Precedence hierarchy explicitly established.
  - 109/109 executable test pass rate confirmed.
  - 0 production code files or test files modified.

* **FINAL SYSTEM CLASSIFICATION:**
  ```text
  SYSTEM ALGORITHM AUDIT — CRITICAL FINDINGS
  ```
  *(Reason: 2 Critical risks—RSK-001 fault clear on STOP and RSK-002 spinlock deadlock—require human engineering review before production deployment, although system remains fully documented and verifiable on test bench).*
