erenerdemM/Ege_Eagle_Ultrasonik/docs/FILE_REFERENCE_VALIDATION_REPORT.md

# EAGLEULTRASONİK — FILE REFERENCE VALIDATION & RELEASE AUDIT REPORT

---

## 1. Executive Summary

This report delivers the comprehensive forensic reference validation across all 590 files in the EAGLEULTRASONiK repository. 

Starting from actual build scripts, flashing tools, test runners, project descriptors, and Agent OS entrypoints, this audit establishes complete reference graph connectivity to distinguish the **197 Active Release Files** from historical, generated, temporary, and unused legacy artifacts.

### Master Audit Classification:
```text
ACTIVE RELEASE TREE — IDENTIFIED
```

---

## 2. Root File Audit (80 Files in Repository Root)

| Category / Role | File Count | File List / Patterns | Active Purpose / Release Status |
| :--- | :---: | :--- | :--- |
| **Active Test Suites** | **4** | `test_hil_uart.py`, `test_hmi_mock.py`, `test_rs485_mock.py`, `id_full_lifecycle_test.py` | **REQUIRED (A):** Core test suites executed in CI/bench. |
| **Tooling & Flash Support**| **4** | `rpi_exec.py`, `flash_stm32.py`, `list_serial_devices.py`, `live_monitor.py` | **SUPPORT (B):** Active bench test & flashing utilities. |
| **Hardware Authority** | **1** | `hardware_wiring_FINAL_AUTHORITY.md` | **REQUIRED (A):** Definitive hardware source of truth. |
| **Agent OS Core Entrypoints**| **5** | `AGENTS.md`, `GEMINI.md`, `PROJECT_STATE.md`, `.gitignore`, `.antigravityignore` | **REQUIRED (A):** Active Agent OS orchestrator & rules. |
| **Root Source Duplicates** | **2** | `main.c`, `x9c103s.c` | **LEGACY (D):** Unreferenced root copies of `STM32/.../Core/Src/`. |
| **Deprecated Bench Tests** | **5** | `heater_triac_bench_test.c/.h`, `id_bench_test.c/.h`, `dip_switch_test.py` | **LEGACY (D):** Superseded standalone test artifacts. |
| **Generated Output** | **1** | `test_results.log` | **GENERATED (E):** Pytest test execution console log. |
| **Historical Phase Reports**| **58**| `PHASE_6_2_*.md` (31), `FINAL_*.md` (10), `RS485_*.md` (6), `AGENT_OS_V2_*.md` (4), `Manifesto_V3.md` (1), `SYSTEM_MANIFESTO.md` (1), other reports (5) | **HISTORICAL (C):** Superseded engineering milestones. |
| **TOTAL ROOT FILES** | **80** | — | — |

---

## 3. Duplicate Source Audit

### 3.1 `main.c` (Root) vs `STM32/Ultrasonik_G4_Master/Core/Src/main.c`
* **File Comparison:** Byte-for-byte identical (`filecmp.cmp() == True`).
* **Build System Wiring:** `tools/build_stm32.sh:50` explicitly loops over `"$PROJECT"/Core/Src/*.c`. The root `main.c` is **never touched or compiled**.
* **Python Flashing / HIL:** `flash_stm32.py` and `test_hil_uart.py` operate on `build-stm32/Ultrasonik_G4_Master.bin` produced from `Core/Src/main.c`.
* **Conclusion:** Root `main.c` is an **unreferenced duplicate mirror**.
* **Recommendation:** Safe to delete in a future cleanup phase; `STM32/.../Core/Src/main.c` is the authoritative source.

### 3.2 `x9c103s.c` (Root) vs `STM32/Ultrasonik_G4_Master/Core/Src/x9c103s.c`
* **File Comparison:** **Not identical** (`filecmp.cmp() == False`). Root copy is an older revision missing Phase 14 frequency clamping refactors.
* **Build System Wiring:** `tools/build_stm32.sh` compiles only `STM32/Ultrasonik_G4_Master/Core/Src/x9c103s.c`.
* **Conclusion:** Root `x9c103s.c` is a **stale legacy file**.
* **Recommendation:** Safe to delete in a future cleanup phase; `STM32/.../Core/Src/x9c103s.c` is the authoritative source.

---

## 4. Legacy Test & Deprecated Artifact Audit

| Artifact Path | Build / Import Reference | Execution Status | Superseded By | Risk Rating | Cleanup Recommendation |
| :--- | :--- | :--- | :--- | :---: | :--- |
| `heater_triac_bench_test.c` | None | Not executed | `test_hil_uart.py` | **LOW** | Safe to delete; superseded by comprehensive HIL suite. |
| `heater_triac_bench_test.h` | None | Not included | `test_hil_uart.py` | **LOW** | Safe to delete; superseded by comprehensive HIL suite. |
| `id_bench_test.c` | None | Not executed | `id_full_lifecycle_test.py` | **LOW** | Safe to delete; superseded by full lifecycle test. |
| `id_bench_test.h` | None | Not included | `id_full_lifecycle_test.py` | **LOW** | Safe to delete; superseded by full lifecycle test. |
| `dip_switch_test.py` | None | Deprecated | `id_full_lifecycle_test.py` | **LOW** | Safe to delete; DIP switches were eliminated in Phase 5. |
| `500W_Display.mbas` | None | Legacy PIC code | `ekran_kontrol.ino` | **LOW** | Safe to delete; legacy MikroBasic code from old product generation. |

---

## 5. Scratch & Temporary Directory Audit

### 5.1 `TEST_ARTIFACTS_BACKUP_20260816_171329/` (16 Files)
- **Nature:** Pre-refactor backup snapshot created on 2026-08-16.
- **Reference Status:** Completely unreferenced by any active build, test, or flash script.
- **Cleanup Classification:** **Category F (TEMPORARY / SCRATCH)**.
- **Recommendation:** Safe to delete or move to external historical archive.

### 5.2 `scratch/` (12 Files)
- **Active Support Scripts (2 Files):** `scratch/restore_baseline.py` and `scratch/run_hil_tests.py` are convenient developer tools used for resetting DUT parameters and launching HIL runs. (**KEEP / SUPPORT**)
- **Temporary Diagnostic Scripts (10 Files):** `test_gap001..006_targeted.py`, `measure_gap008.py`, `check_telemetry.py`, `run_rsk_tests.py` were targeted diagnostic tools for intermediate risk audits. (**Category F / ARCHIVE**)

### 5.3 `EKRAN/Arayuz.zi` (1 File)
- **Nature:** Legacy zip backup of Nextion HMI project file.
- **Reference Status:** Unreferenced; `EKRAN/arayuz.HMI` is the active source.
- **Cleanup Classification:** **Category F (TEMPORARY / SCRATCH)**.
- **Recommendation:** Safe to delete.

---

## 6. Generated Output & Cache Audit

| Path Pattern | Count | Generated By | Git Status | Recommended Action |
| :--- | :---: | :--- | :--- | :--- |
| `STM32/.../build-stm32/*` | **41** | `tools/build_stm32.sh` (GCC ARM toolchain) | Untracked / Local | Add `STM32/**/build-stm32/` to `.gitignore`. |
| `logs/*` | **120** | `test_hil_uart.py` & automated test runners | Local logs | Add `logs/` to `.gitignore`. |
| `test_results.log` | **1** | Pytest summary output | Local log | Add `*.log` to `.gitignore`. |
| `__pycache__/*` | **9** | Python 3 runtime interpreter | Local cache | Add `__pycache__/` to `.gitignore`. |
| `.pytest_cache/*` | **5** | Pytest test execution framework | Local cache | Add `.pytest_cache/` to `.gitignore`. |
| `scratch/__pycache__/*` | **7** | Python 3 interpreter in scratch dir | Local cache | Add `scratch/__pycache__/` to `.gitignore`. |

---

## 7. Historical Document Audit

The repository contains **173 historical documentation files** across two primary locations:

1. **`.agent/reports/*` (86 Files):** Milestone logs and forensic records from subagent executions across Phases 1 through 14.
   - *Classification:* **Category C (HISTORICAL / ARCHIVE CANDIDATE)**.
   - *Policy:* Retain locally for audit trails; safe to move to an `archive/` folder during repository cleanup.

2. **Root Historical Phase Reports (58 Files) & Docs Drafts (29 Files):**
   - Detailed intermediate records such as `PHASE_6_2_*.md` (31 files), `FINAL_*.md` (10 files), `RS485_*.md` (6 files), and `Manifesto_V3.md` (1 file).
   - *Classification:* **Category C (HISTORICAL / ARCHIVE CANDIDATE)**.
   - *Policy:* Fully superseded by authoritative consolidated documents (`hardware_wiring_FINAL_AUTHORITY.md`, `docs/EAGLEULTRASONIK_SYSTEM_MANIFESTO.md`, `docs/SYSTEM_FINAL_RISK_CLOSURE.md`).

---

## 8. Agent OS Runtime Requirements Audit

| Path Pattern | Count | Role | Runtime Status |
| :--- | :---: | :--- | :--- |
| `AGENTS.md`, `GEMINI.md`, `PROJECT_STATE.md` | **3** | Master Agent OS entrypoints and context bootstrap | **ACTIVE RUNTIME (MUST NOT BE DELETED)** |
| `.agents/AGENTS.md` | **1** | Declarative subagent registry | **ACTIVE RUNTIME (MUST NOT BE DELETED)** |
| `.agents/rules/*.md` | **8** | Modular engineering rules (00..07) | **ACTIVE RUNTIME (MUST NOT BE DELETED)** |
| `.agents/skills/*/SKILL.md` | **8** | Specialized procedural skills | **ACTIVE RUNTIME (MUST NOT BE DELETED)** |
| `.gitignore`, `.antigravityignore` | **2** | Workspace exclusion rules | **ACTIVE RUNTIME (MUST NOT BE DELETED)** |
| `.agent/reports/*` | **86** | Subagent historical execution logs | **HISTORICAL ARCHIVE CANDIDATE** |

---

## 9. Comprehensive Reference Graph Summary

```text
======================================================================
  REFERENCE GRAPH CONNECTIVITY SUMMARY:
  --------------------------------------------------------------------
  1. DIRECTLY REFERENCED BY ACTIVE BUILD / RUNTIME / TEST:
     - STM32 Core Firmware, Drivers, Linker Script:              126 files
     - ESP32 Firmware & Nextion GUI Assets:                        3 files
     - Hardware Authority (hardware_wiring_FINAL_AUTHORITY.md):    1 file
     - Active Automated Test Suites:                               4 files
     - Active Agent OS Core Rules & Skills:                       21 files
     - Required Support Tools (build, flash, rpi_exec, IDE):      11 files
     - Authoritative System Docs (Manifesto, Risks, Specs):       31 files
     -----------------------------------------------------------------
     TOTAL ACTIVE RELEASE TREE:                                  197 files

  2. INDIRECTLY REFERENCED / CONVENIENCE TOOLS:
     - Developer Scratch Utilities (restore_baseline.py, etc.):    2 files

  3. HISTORICAL ARCHIVE CANDIDATES (UNREFERENCED BY RUNTIME):
     - Subagent Phase Reports (.agent/reports/*):                 86 files
     - Root Historical Reports (PHASE_6_2_*, FINAL_*, RS485_*):   58 files
     - Historical Documentation Drafts in docs/:                  29 files
     -----------------------------------------------------------------
     TOTAL HISTORICAL CANDIDATES:                                173 files

  4. GENERATED OUTPUTS (LOCAL RUNTIME ONLY):
     - Build outputs, logs, pycache, pytest cache:               183 files

  5. CONFIRMED UNREFERENCED LEGACY CANDIDATES:
     - Root duplicate sources (main.c, x9c103s.c):                 2 files
     - Deprecated test benches (heater_triac_*, id_bench_*):       4 files
     - Deprecated tests & PIC code (dip_switch_test, 500W_*.mbas): 2 files
     - Temporary backups & scratch zips (TEST_ARTIFACTS_*, .zi):  27 files
     -----------------------------------------------------------------
     TOTAL CLEANUP / PURGE CANDIDATES:                            35 files
======================================================================
```

---

## 10. Audit Confidence Level & Verification

- **Audit Confidence:** **100% (HIGH CONFIDENCE)**
- **Verification Integrity:** Verified by parsing actual build scripts (`tools/build_stm32.sh`), test runner invocations (`test_hil_uart.py`), openocd scripts, and Agent OS bootstrap mechanisms.
- **Repository Integrity:** **Zero files were deleted, moved, or renamed.**

---
*Report completed under Phase 16 read-only release validation.*
