erenerdemM/Ege_Eagle_Ultrasonik/docs/SYSTEM_FINAL_RISK_CLOSURE.md

# EAGLEULTRASONİK — SYSTEM FINAL RISK CLOSURE REPORT

---

## 1. Executive Summary

This report establishes the single, authoritative, reconciled risk baseline for the EAGLEULTRASONiK industrial controller project across all firmware, protocol, HMI, and hardware validation domains.

Following the successful execution, mock suite validation, and physical hardware-in-the-loop (HIL) verification of **Priority 0** and **Priority 1** remediation batches, all safety-critical and functional defects are closed. Remaining engineering improvements and production enhancements are formally categorized with zero prototype-blocking issues.

### Master Baseline Classifications:
```text
FINAL RISK BASELINE — RECONCILED
SOFTWARE / LOOP PROTOTYPE — READY FOR FINAL CLOSURE
FINAL HARDWARE VALIDATION — DEFERRED (DR-001, DR-002, DR-003)
```

---

## 2. Risk Ledger Reconciliation Matrix (RSK-001 .. RSK-015 & DR-001 .. DR-003)

| Risk / Item ID | Priority | Subsystem / Domain | Title / Focus | Final Status | Evidence Basis | Prototype Impact | Production Impact |
| :--- | :--- | :--- | :--- | :--- | :--- | :--- | :--- |
| **RSK-001** | P0 | STM32 State Machine | Fault Persistence on STOP Command | **CLOSED** | Phase 14 Fix + Physical HIL (`test_rsk001`) | Safe | Resolved |
| **RSK-002** | P0 | STM32 UART Driver | Spinlock Timeout Guard in TX Path | **CLOSED** | Phase 14 Fix + Physical HIL (`test_rsk002`) | Safe | Resolved |
| **RSK-003** | P0 | STM32 / ESP32 | Active Mode Setpoint Touch Lockout | **CLOSED** | Phase 14 Fix + Physical HIL (`test_rsk003`) | Safe | Resolved |
| **RSK-004** | P1 | ESP32 HMI Master | Slave Response Blind Spot (`ERR:`, `NACK`, `ACK:`) | **CLOSED** | Phase 16 Batch 2 + Physical HIL (`test_rsk004`) | Safe | Resolved |
| **RSK-005** | P1 | STM32 UART Driver | Telemetry Buffer Boundary Over-Read Clamp | **CLOSED** | Phase 16 Batch 1 + Physical HIL (`test_rsk005`) | Safe | Resolved |
| **RSK-006** | P1 | STM32 / ESP32 | DEGAS Mode Commissioning Interlock | **CLOSED** | Phase 16 Batch 1 + Physical HIL (`test_rsk006`) | Safe | Resolved |
| **RSK-007** | P1 | STM32 UART Driver | UART RX Error Callback Re-arm Guarantee | **CLOSED** | Phase 16 Batch 1 + Physical HIL (`test_rsk007`) | Safe | Resolved |
| **RSK-008** | P1 | ESP32 HMI Security | Service PIN Auth on Admin & Recipe Commands | **CLOSED** | Phase 16 Batch 2 + Physical HIL (`test_rsk008`) | Safe | Resolved |
| **RSK-009** | P1 | ESP32 HMI Watchdog | RS485 Disconnect Stale UI Synchronization | **CLOSED** | Phase 16 Batch 2 + Physical HIL (`test_rsk009`) | Safe | Resolved |
| **RSK-010** | P2 | STM32 Flash Driver | Global IRQ Disabling During Flash Erase in IDLE | **SHOULD FIX BEFORE PRODUCTION** | Phase 16 Triage (`docs/P2_P3_FINAL_TRIAGE_REPORT.md`) | Non-blocking | Mask IRQs / Dual-Bank |
| **RSK-011** | P2 | STM32 State Machine | Multi-Word Struct Read in EXTI ISR Context | **SAFE TO DEFER** | Phase 16 Triage (Immutable during active DEGAS) | Non-blocking | Shadow Buffer |
| **RSK-012** | P2 | STM32 Telemetry | Unchecked Float-to-Int Conversion Cast | **SAFE TO DEFER** | Phase 16 Triage (ADC range strictly bounded) | Non-blocking | Explicit Clamp |
| **RSK-013** | P2 | RS485 Protocol | Lack of CRC Checksum on Standard ASCII Frames | **SHOULD FIX BEFORE PRODUCTION** | Phase 16 Triage (Field delimiter & range clamping active)| Non-blocking | Append CRC8 Tail |
| **RSK-014** | P3 | ESP32 HMI UX | Fixed 5-Minute Service Session Timeout | **SAFE TO DEFER** | Phase 16 Triage (Standard security auto-logout) | Non-blocking | Touch Refresh |
| **RSK-015** | P3 | STM32 UART Driver | Single-Byte RX Interrupt Overhead at 115200 Baud | **SAFE TO DEFER** | Phase 16 Triage (<0.5% CPU load at 170 MHz) | Non-blocking | Circular DMA |
| **DR-001** | Hardware | Analog / Thermal Load | PT100 Sensor & AC Heater Load Revalidation | **HARDWARE-DEFERRED** | Specialized physical bench load unavailable | Deferred | High-voltage bench |
| **DR-002** | Hardware | Acoustic Transducer | Ultrasonic Transducer & Power Card Resonance | **HARDWARE-DEFERRED** | Specialized acoustic tank unavailable | Deferred | Liquid tank bench |
| **DR-003** | Hardware | Cavitation / Chemistry | Liquid Tank DEGAS Dissolved Oxygen Reduction | **HARDWARE-DEFERRED** | Dissolved oxygen meter unavailable | Deferred | Wet chemical bench |

---

## 3. Mathematical Consistency & Category Breakdown

```text
======================================================================
  TOTAL SOFTWARE RISK ITEMS (RSK-001 .. RSK-015):                 15
    - 1. CLOSED:                                                   9 (RSK-001 .. RSK-009)
    - 2. SHOULD FIX BEFORE PRODUCTION:                             2 (RSK-010, RSK-013)
    - 3. SAFE TO DEFER:                                            4 (RSK-011, RSK-012, RSK-014, RSK-015)
    - Check Sum: 9 + 2 + 4 = 15 [CONSISTENT]

  TOTAL HARDWARE-DEFERRED VALIDATION ITEMS (DR-001 .. DR-003):      3
    - 4. HARDWARE-DEFERRED:                                        3 (DR-001, DR-002, DR-003)
    - Check Sum: 3 = 3 [CONSISTENT]

  TOTAL COMBINED AUDITED ITEMS:                                   18
    - Total Check: 15 Software + 3 Hardware = 18 [100% CONSISTENT]
======================================================================
```

---

## 4. Categorical Deep-Dive Analysis

### 4.1 Category 1: CLOSED (9 Items — All P0 and P1 Risks)

All 9 P0 and P1 risks are completely resolved, tested in software mock environments, and verified on real physical hardware:

1. **RSK-001 (P0):** `SystemState_SafeStop` preserves non-zero hardware fault flags on user STOP. Verified by `test_rsk001` (**PASS**).
2. **RSK-002 (P0):** Bounded spinlock iteration counter prevents UART TX freeze. Verified by `test_rsk002` (**PASS**).
3. **RSK-003 (P0):** Nextion touch inputs and serial setpoint updates locked during RUNNING/DEGAS cycles. Verified by `test_rsk003` (**PASS**).
4. **RSK-004 (P1):** ESP32 HMI parser captures slave rejection frames (`ERR:`, `NACK`, `ACK:`) and updates `t_durum.txt`. Verified by `test_rsk004` (**PASS**).
5. **RSK-005 (P1):** Buffer boundary clamp prevents `snprintf` over-read in telemetry generation. Verified by `test_rsk005` (**PASS**).
6. **RSK-006 (P1):** Commissioning commands (`STAGE_ID`, `ASSIGN_ID`, `RESET_ID`) rejected in DEGAS mode. Verified by `test_rsk006` (**PASS**).
7. **RSK-007 (P1):** UART error callback clears ORE/NE/FE/PE flags and re-arms IT reception. Verified by `test_rsk007` (**PASS**).
8. **RSK-008 (P1):** Service PIN (`123456`) gating enforced on `P_SAVE|...`, `CMD_SET_STEP_INC:`, `CMD_SET_SWP_SPAN:`, `CMD_SET_SWP_PER:`. Verified by `test_rsk008` (**PASS**).
9. **RSK-009 (P1):** RS485 communication loss updates `durum_metni[i] = "Kart Yok!"` and resets countdown. Verified by `test_rsk009` (**PASS**).

---

### 4.2 Category 2: SHOULD FIX BEFORE PRODUCTION (2 Items)

These items do not impair prototype operation, but represent production hardening requirements for industrial deployment:

1. **RSK-010 (P2 — Flash Erase Interrupt Masking):** In production firmware, replace global `__disable_irq()` with NVIC priority masking (`__set_BASEPRI()`) so that high-priority peripheral interrupts remain active during Tank ID provisioning.
2. **RSK-013 (P2 — RS485 Protocol CRC8 Tail):** In production protocol revision, append an optional CRC8 tail to ASCII control and telemetry frames to enhance immunity against severe industrial EMI transients.

---

### 4.3 Category 3: SAFE TO DEFER (4 Items)

These items are confirmed safe for the current system architecture and do not require modification before prototype release:

1. **RSK-011 (P2 — EXTI ISR State Read):** Struct parameters (`degas_config`) are immutable during active operation; 32-bit scalar fields are read atomically on Cortex-M4.
2. **RSK-012 (P2 — Telemetry Float-to-Int Cast):** `current_temp_c` is strictly bounded by ADC hardware thresholds; float overflows or NaN values cannot occur.
3. **RSK-014 (P3 — Service Session Inactivity Timer):** 5-minute fixed timeout enforces standard defensive security posture.
4. **RSK-015 (P3 — Single-Byte UART Interrupt Overhead):** 11.5 kHz interrupt rate consumes <0.5% CPU load on 170 MHz STM32G474RET6 core.

---

### 4.4 Category 4: HARDWARE-DEFERRED (3 Items — Strictly Non-Software)

These items represent physical acoustic, high-voltage thermal, and wet chemical qualifications that require specialized laboratory equipment:

1. **DR-001:** Physical PT100 probe linearity and 220V AC Triac heater regulation under thermal load.
2. **DR-002:** Ultrasonic acoustic transducer resonance tracking and acoustic cavitation profiling across 25kHz–43kHz.
3. **DR-003:** Liquid DEGAS dissolved oxygen reduction verification in fluid tank.

---

## 5. Verification Summary

```text
======================================================================
  MOCK TEST SUITES:
    - test_hmi_mock.py:                                55 / 55 PASSED
    - test_rs485_mock.py:                              37 / 37 PASSED
    - Total Mock Tests:                                92 / 92 PASSED (100%)

  PHYSICAL HIL TEST SUITE (STM32G474RET6 Target via OpenOCD / ST-Link V3):
    - test_hil_uart.py:                                40 / 40 PASSED (100%)
    - Execution Time:                                  97.35s
    - Regression Failures:                             0
======================================================================
```

---

## 6. Final Project Authority Statements

```text
FINAL RISK BASELINE — RECONCILED
SOFTWARE / LOOP PROTOTYPE — READY FOR FINAL CLOSURE
FINAL HARDWARE VALIDATION — DEFERRED (DR-001, DR-002, DR-003)
```

---
*Report generated and validated under Phase 16: Final System Risk Closure Reconciliation. Zero source code or test files modified.*
