erenerdemM/Ege_Eagle_Ultrasonik/docs/SYSTEM_RISK_RECONCILIATION_REPORT.md

# EAGLEULTRASONİK — SYSTEM RISK REGISTER RECONCILIATION REPORT

---

## 1. Executive Summary

This report presents the reconciled, mathematically verified risk ledger for the EAGLEULTRASONiK system following Phase 12 auditing.

During this reconciliation pass, every registered risk item (RSK-001 through RSK-015, plus DR-001) was assigned **exactly one classification** in the master ledger, resolving internal text inconsistencies from earlier preliminary audit drafts.

### Authoritative Reconciliation Totals:
* **Total Ledger Items:** **16 Items** (RSK-001 .. RSK-015 + DR-001)
* **CONFIRMED DEFECTS:** **8** (RSK-001, RSK-002, RSK-003, RSK-004, RSK-005, RSK-008, RSK-009, RSK-014)
* **CONFIRMED DESIGN RISKS:** **5** (RSK-006, RSK-007, RSK-011, RSK-013, RSK-015)
* **CONDITIONAL RISKS:** **2** (RSK-010, RSK-012)
* **FALSE POSITIVES:** **0**
* **UNVERIFIED:** **0**
* **HARDWARE-DEFERRED:** **1** (`DR-001` / `test_17`)
* **Code / File Modifications:** **0 Files Modified.**

---

## 2. Documented Text Inconsistencies & Corrections

In previous preliminary draft text (Phase 11 summary narrative), a typographical error stated `"7 confirmed defects"`, while listing 8 explicit risk IDs in the detailed table below it (RSK-001, RSK-002, RSK-003, RSK-004, RSK-005, RSK-008, RSK-009, RSK-014).

This Phase 12 reconciliation formally corrects the summary narrative count from 7 to **8 CONFIRMED DEFECTS**, restoring 100% internal arithmetic consistency across the category totals and priority totals.

---

## 3. Authoritative Risk Ledger

| Risk ID | Title / Target Area | Category Classification | Priority Assignment | Single Category Assignment | Confidence |
| :--- | :--- | :--- | :--- | :--- | :--- |
| **RSK-001** | Hardware Fault Bypass on `STOP` Command | **CONFIRMED DEFECT** | **P0** | CONFIRMED DEFECT | **HIGH** |
| **RSK-002** | Spinlock Deadlock in `RS485_Transmit_Blocking` | **CONFIRMED DEFECT** | **P0** | CONFIRMED DEFECT | **HIGH** |
| **RSK-003** | Touch Lockout Omissions During Wash Cycle | **CONFIRMED DEFECT** | **P0** | CONFIRMED DEFECT | **HIGH** |
| **RSK-004** | ESP32 Master Blind Spot for ACK/NACK/ERR | **CONFIRMED DEFECT** | **P1** | CONFIRMED DEFECT | **HIGH** |
| **RSK-005** | Out-of-Bounds Buffer Read in Telemetry Format | **CONFIRMED DEFECT** | **P1** | CONFIRMED DEFECT | **HIGH** |
| **RSK-006** | Asymmetric DEGAS Provisioning Interlock | **CONFIRMED DESIGN RISK** | **P1** | CONFIRMED DESIGN RISK | **HIGH** |
| **RSK-007** | Unhandled Return Statuses of HAL Drivers | **CONFIRMED DESIGN RISK** | **P1** | CONFIRMED DESIGN RISK | **HIGH** |
| **RSK-008** | Unauthenticated Administrative Config Commands | **CONFIRMED DEFECT** | **P1** | CONFIRMED DEFECT | **HIGH** |
| **RSK-009** | Stale UI Status Display on RS485 Disconnect | **CONFIRMED DEFECT** | **P1** | CONFIRMED DEFECT | **HIGH** |
| **RSK-010** | Disabling IRQs During Flash Page Erase | **CONDITIONAL RISK** | **P2** | CONDITIONAL RISK | **MEDIUM** |
| **RSK-011** | Multi-Word `g_system_state` Data Race | **CONFIRMED DESIGN RISK** | **P2** | CONFIRMED DESIGN RISK | **HIGH** |
| **RSK-012** | Unchecked Float-to-Int Telemetry Cast | **CONDITIONAL RISK** | **P2** | CONDITIONAL RISK | **MEDIUM** |
| **RSK-013** | Lack of CRC Validation on Standard ASCII Frames | **CONFIRMED DESIGN RISK** | **P2** | CONFIRMED DESIGN RISK | **HIGH** |
| **RSK-014** | Service Session Inactivity Timer No-Refresh | **CONFIRMED DEFECT** | **P3** | CONFIRMED DEFECT | **HIGH** |
| **RSK-015** | Single-Byte RX Interrupt Overhead at 115k Baud | **CONFIRMED DESIGN RISK** | **P3** | CONFIRMED DESIGN RISK | **HIGH** |
| **DR-001** | Physical PT100 Sensor Probe Readback (`test_17`) | **HARDWARE-DEFERRED** | **DEFERRED** | HARDWARE-DEFERRED | **HIGH** |

---

## 4. Mathematical Verification of Totals

### A. Category Totals vs. Ledger
$$\begin{aligned}
\text{CONFIRMED DEFECT} &= 8 \quad (\text{RSK-001, 002, 003, 004, 005, 008, 009, 014}) \\
\text{CONFIRMED DESIGN RISK} &= 5 \quad (\text{RSK-006, 007, 011, 013, 015}) \\
\text{CONDITIONAL RISK} &= 2 \quad (\text{RSK-010, 012}) \\
\text{FALSE POSITIVE} &= 0 \\
\text{UNVERIFIED} &= 0 \\
\text{HARDWARE-DEFERRED} &= 1 \quad (\text{DR-001}) \\
\hline
\mathbf{Total\ Category\ Items} &\mathbf{= 16\ Items\ (100\%\ Verified)}
\end{aligned}$$

### B. Priority Totals vs. Ledger
$$\begin{aligned}
\mathbf{P0\ (Must\ Resolve\ Before\ Feature\ Work)} &= 3 \quad (\text{RSK-001, RSK-002, RSK-003}) \\
\mathbf{P1\ (Must\ Resolve\ Before\ Release)} &= 6 \quad (\text{RSK-004, RSK-005, RSK-006, RSK-007, RSK-008, RSK-009}) \\
\mathbf{P2\ (Engineering\ Improvement)} &= 4 \quad (\text{RSK-010, RSK-011, RSK-012, RSK-013}) \\
\mathbf{P3\ (Documentation\ /\ Minor)} &= 2 \quad (\text{RSK-014, RSK-015}) \\
\mathbf{DEFERRED\ (Hardware\ Unavailable)} &= 1 \quad (\text{DR-001}) \\
\hline
\mathbf{Total\ Priority\ Items} &\mathbf{= 16\ Items\ (100\%\ Verified)}
\end{aligned}$$

---

## 5. Conclusion

The EAGLEULTRASONİK risk ledger is 100% reconciled with zero category ambiguity and complete mathematical integrity across all 16 items.
