erenerdemM/Ege_Eagle_Ultrasonik/STM32/Ultrasonik_G4_Master/Core/Inc/main.h

#define B1_Pin GPIO_PIN_13
#define B1_GPIO_Port GPIOC
#define B1_EXTI_IRQn EXTI15_10_IRQn
#define RCC_OSC32_IN_Pin GPIO_PIN_14
#define RCC_OSC32_IN_GPIO_Port GPIOC
#define RCC_OSC32_OUT_Pin GPIO_PIN_15
#define RCC_OSC32_OUT_GPIO_Port GPIOC
#define RCC_OSC_IN_Pin GPIO_PIN_0
#define RCC_OSC_IN_GPIO_Port GPIOF
#define RCC_OSC_OUT_Pin GPIO_PIN_1
#define RCC_OSC_OUT_GPIO_Port GPIOF
#define LPUART1_TX_Pin GPIO_PIN_2
#define LPUART1_TX_GPIO_Port GPIOA
#define LPUART1_RX_Pin GPIO_PIN_3
#define LPUART1_RX_GPIO_Port GPIOA
#define LD2_Pin GPIO_PIN_5
#define LD2_GPIO_Port GPIOA
#define X9C_CS_Pin GPIO_PIN_12
#define X9C_CS_GPIO_Port GPIOB
#define X9C_UD_Pin GPIO_PIN_13
#define X9C_UD_GPIO_Port GPIOB
#define X9C_INC_Pin GPIO_PIN_14
#define X9C_INC_GPIO_Port GPIOB
#define HEATER_RELAY_Pin GPIO_PIN_15
#define HEATER_RELAY_GPIO_Port GPIOB
#define T_SWDIO_Pin GPIO_PIN_13
#define T_SWDIO_GPIO_Port GPIOA
#define T_SWCLK_Pin GPIO_PIN_14
#define T_SWCLK_GPIO_Port GPIOA
#define T_SWO_Pin GPIO_PIN_3
#define T_SWO_GPIO_Port GPIOB
#define HEATER_TEST_FB_Pin GPIO_PIN_4
#define HEATER_TEST_FB_GPIO_Port GPIOA
#define TRIAC_TEST_FB_Pin GPIO_PIN_6
#define TRIAC_TEST_FB_GPIO_Port GPIOA
#define RS485_DE_Pin GPIO_PIN_1
#define RS485_DE_GPIO_Port GPIOB
#define TRIAC_GATE_Pin GPIO_PIN_6
#define TRIAC_GATE_GPIO_Port GPIOC
#define ZERO_CROSS_Pin GPIO_PIN_7
#define ZERO_CROSS_GPIO_Port GPIOC
