erenerdemM/Ege_Eagle_Ultrasonik/(commit log)

2026-08-09 feat: initialize core system architecture and control manifests
    [Ultrasonik_G4_Master.cfg]
2026-08-14 feat: finalize embedded firmware, Agent OS V2, and HIL verification baseline
    [FINAL_SYSTEM_WIRING_TABLE.csv]
2026-08-14 fix: finalize production DIP and zero-crossing configuration
    [main.c, ultrasonic_pwm.c]
2026-08-14 build: add reproducible STM32 GCC build script
2026-08-17 release: EAGLEULTRASONiK software-loop prototype baseline
    EAGLEULTRASONiK software/loop prototype release baseline.
    Included capabilities:
    - STM32G474RE firmware control architecture
    - ESP32-S3 master and Nextion HMI integration
    - RS485 multi-drop ASCII communication
    - UID-based DIP-free tank identity/provisioning
    - multi-tank T1..T10 addressing and isolation
    - normal process execution and SafeStop behavior
    - dual-frequency operation (28 kHz / 40 kHz)
    - configurable Frequency Sweep architecture
    - configurable DEGAS workflow with service parameters
    - optional DEGAS temperature-control framework
    - per-tank DEGAS configuration persistence
    - service settings architecture
    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
    [FINAL_SYSTEM_WIRING_TABLE.csv]
2026-08-23 STM32: lock in validated X9C103S control and PA0 feedback baseline
    - X9C103S startup wiper synchronization
    - NO-STORE deselect behavior
    - DWT-based X9C timing
    - 28/40 kHz calibrated X9C taps
    - validated sweep control
    - PA0 ADC1 VW feedback path
    - PA0 ADC settling/sampling fix
    - preserve PT100 ADC separation
    [main.c, x9c103s.c, x9c103s.h]
2026-08-23 STM32/ESP32: fix sweep arm active state synchronization
    [ekran_kontrol.ino, esp32_uart.c, rpi_hmi_bridge.py, system_state.c, x9c103s.c]
2026-08-24 feat(system): release V4.0.0 baseline with persistent sweep ARM/ACTIVE, arbitrary DEGAS frequency, and System Manifesto V4
2026-08-24 feat(heater): implement dual-mode heater control (Relay Bang-Bang + SSR PID) and update V4 manifesto
