erenerdemM/Ege_Eagle_Ultrasonik/(notices)

Notices in the files:
STM32/Ultrasonik_G4_Master/Core/Inc/main.h:
Copyright (c) 2026 STMicroelectronics.
All rights reserved.
This software is licensed under terms that can be found in the LICENSE file
